mojca/midiatonerca/3d-design/revision6/FullPlate_68x52_4mm_lever2_4_5.dxf

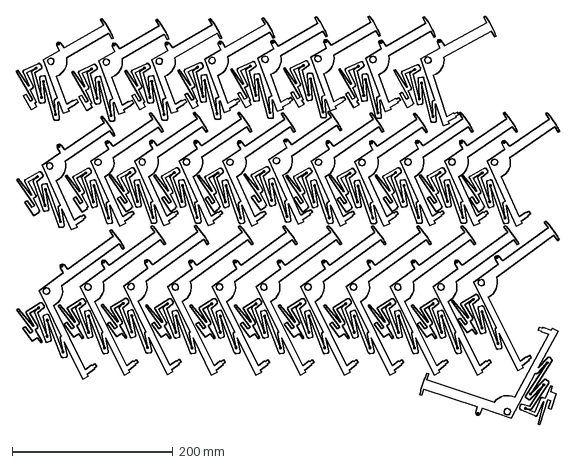
[picture p1: CAD file, 2017-07-26]
3d-design/revision6/FullPlate_68x52_4mm_lever2_4_5.dxf
675.1 x 508.0 mm
