mojca/midiatonerca/3d-design/revision6/FullPlate_53x42_3mm_lever3_32pieces.dxf

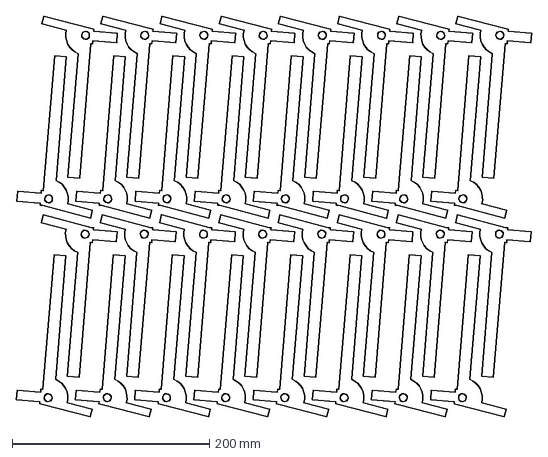
[picture p2: CAD file, 2017-07-26]
3d-design/revision6/FullPlate_53x42_3mm_lever3_32pieces.dxf
522.5 x 406.2 mm
