mojca/midiatonerca/3d-design/revision6/FullPlate_68x40_4mm_frame_aligners.dxf

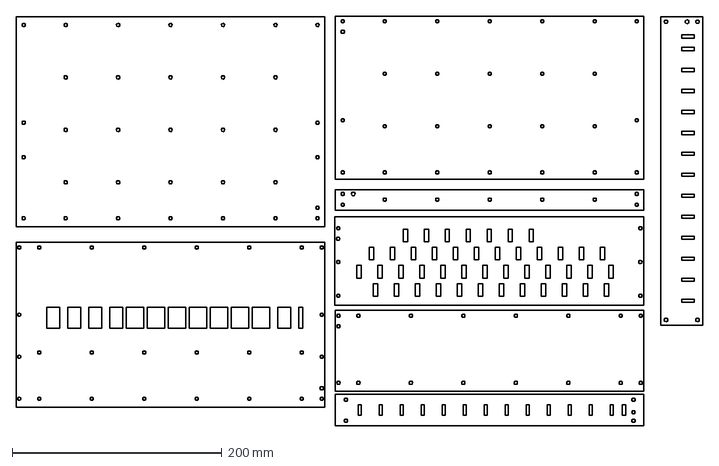
[picture p3: CAD file, 2017-07-26]
3d-design/revision6/FullPlate_68x40_4mm_frame_aligners.dxf
654.0 x 390.5 mm
