mojca/midiatonerca/3d-design/revision6/FullPlate_68x40_4mm_interrupter_omegaholder_lever1_sparelevers.dxf

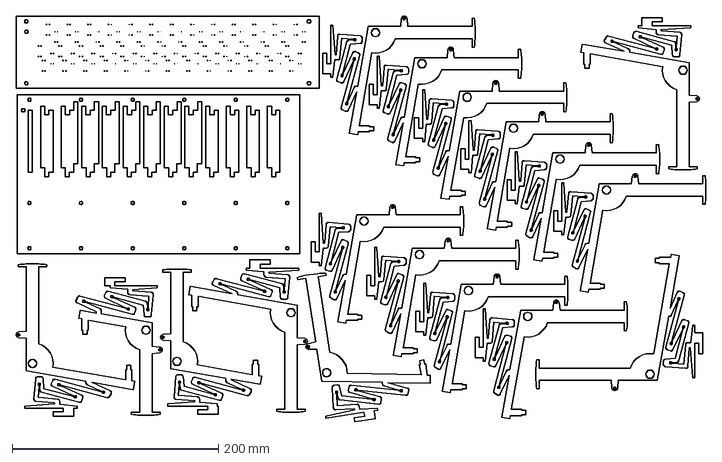
[picture p4: CAD file, 2017-07-26]
3d-design/revision6/FullPlate_68x40_4mm_interrupter_omegaholder_lever1_sparelevers.dxf
668.8 x 393.2 mm
