mojca/midiatonerca/3d-design/revision6/Lever1vH.DXF

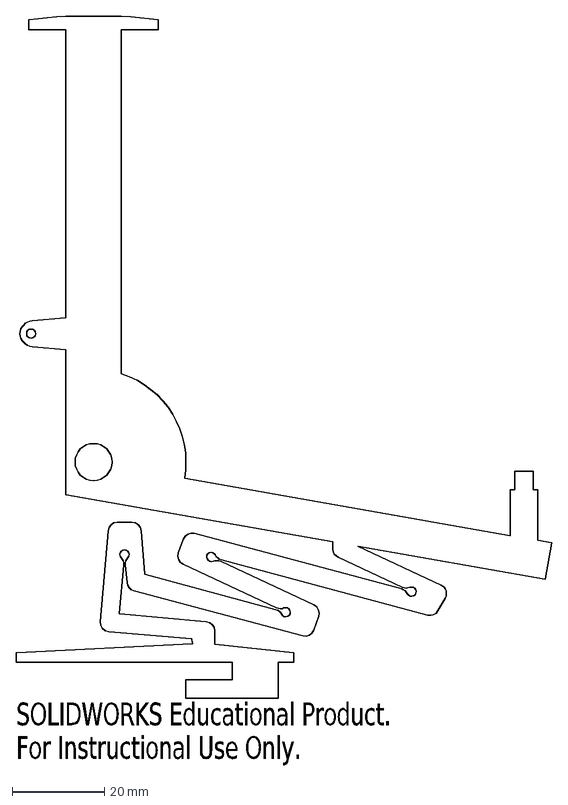
[picture p5: CAD file, 2017-07-26]
3d-design/revision6/Lever1vH.DXF
SOLIDWORKS Educational Product.
For Instructional Use Only.
