mojca/midiatonerca/3d-design/svg-plates/keyboard-holes-for-switches-only/keyboard-holes-for-switches-only-2.dxf

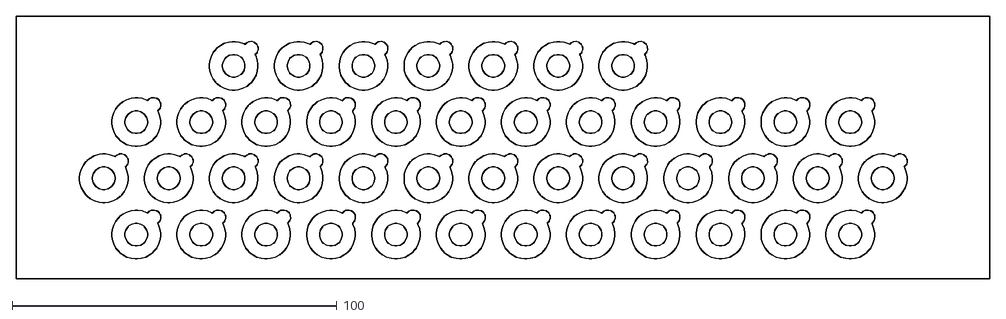
[picture p6: CAD file, 2017-07-27]
3d-design/svg-plates/keyboard-holes-for-switches-only/keyboard-holes-for-switches-only-2.dxf
300.0 x 81.0
