mojca/midiatonerca/3d-design/svg-plates/opto/optocoupler-board.dxf

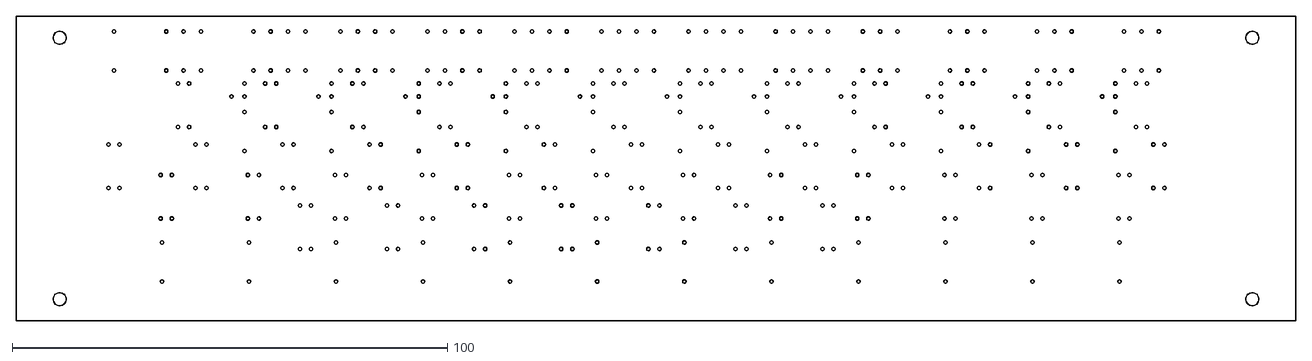
[picture p7: CAD file, 2017-07-28]
3d-design/svg-plates/opto/optocoupler-board.dxf
294.0 x 70.0
