mojca/midiatonerca/3d-design/revision6/OmegaSpringHolderH.DXF

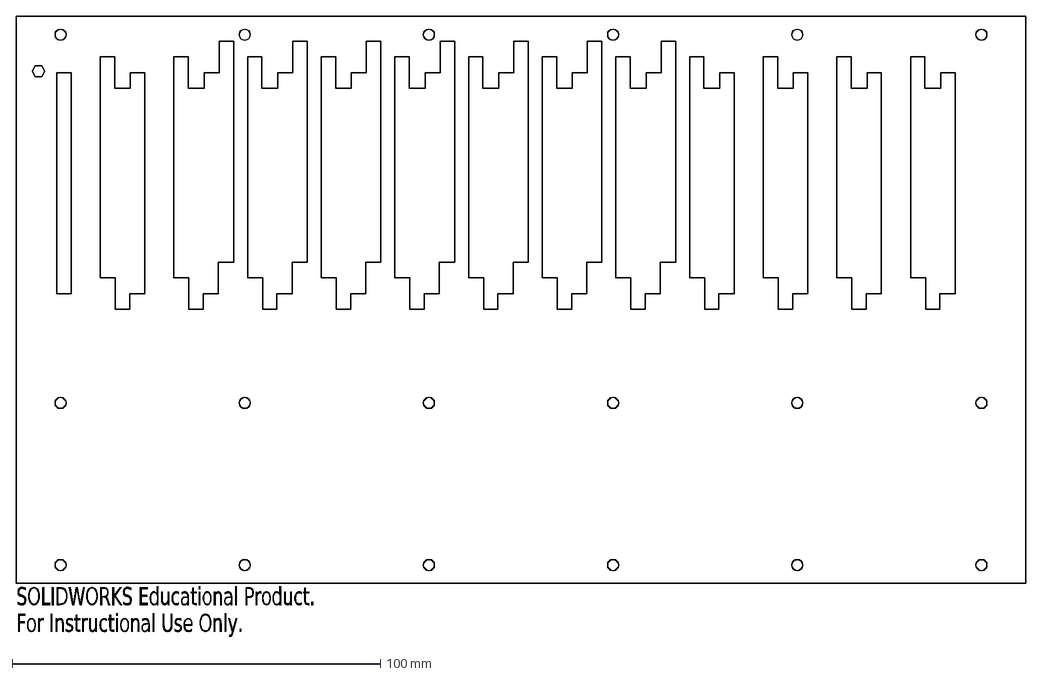
[picture p8: CAD file, 2017-07-26]
3d-design/revision6/OmegaSpringHolderH.DXF
SOLIDWORKS Educational Product.
For Instructional Use Only.
