mojca/midiatonerca/3d-design/svg-plates/keyboard-holes-for-switches-only/keyboard-holes-for-switches-only-3.dxf

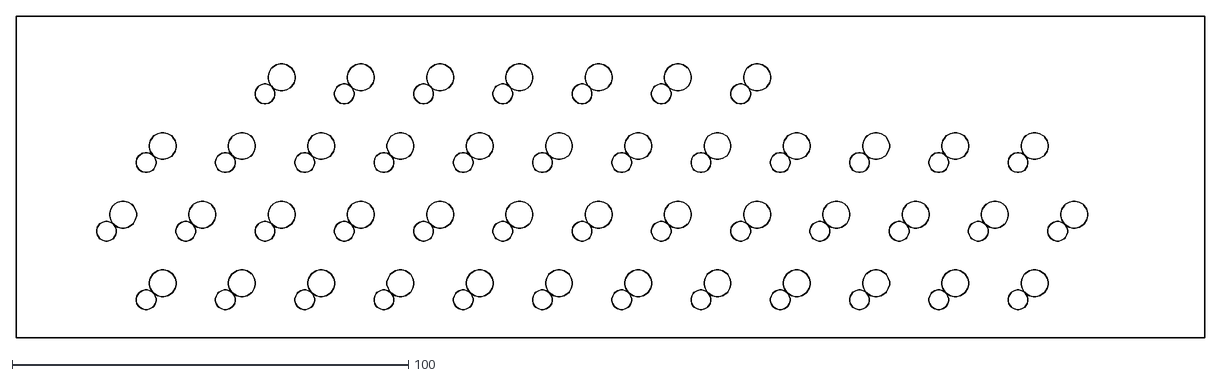
[picture p9: CAD file, 2017-07-26]
3d-design/svg-plates/keyboard-holes-for-switches-only/keyboard-holes-for-switches-only-3.dxf
300.0 x 81.0
