mojca/midiatonerca/3d-design/revision6/BottomPlateH.DXF

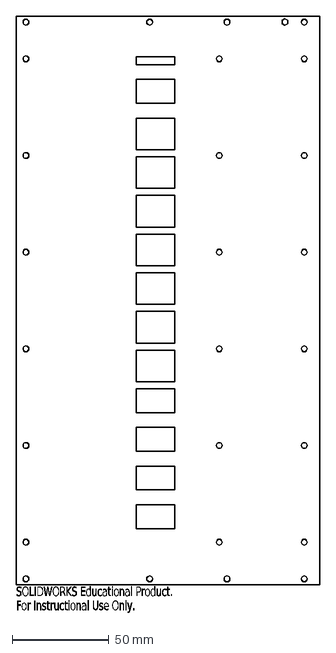
[picture p10: CAD file, 2017-07-26]
3d-design/revision6/BottomPlateH.DXF
SOLIDWORKS Educational Product.
For Instructional Use Only.
