mojca/midiatonerca/3d-design/revision6/KeyboardPlateH.DXF

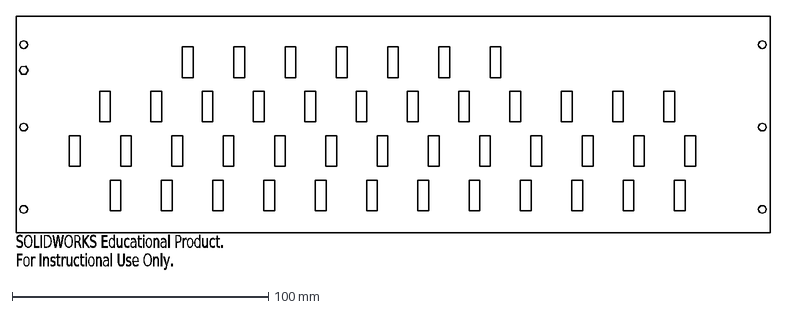
[picture p11: CAD file, 2017-07-26]
3d-design/revision6/KeyboardPlateH.DXF
SOLIDWORKS Educational Product.
For Instructional Use Only.
