mojca/midiatonerca/3d-design/svg-plates/keyboard-holes-for-switches-only/keyboard-holes-for-switches-only-1.dxf

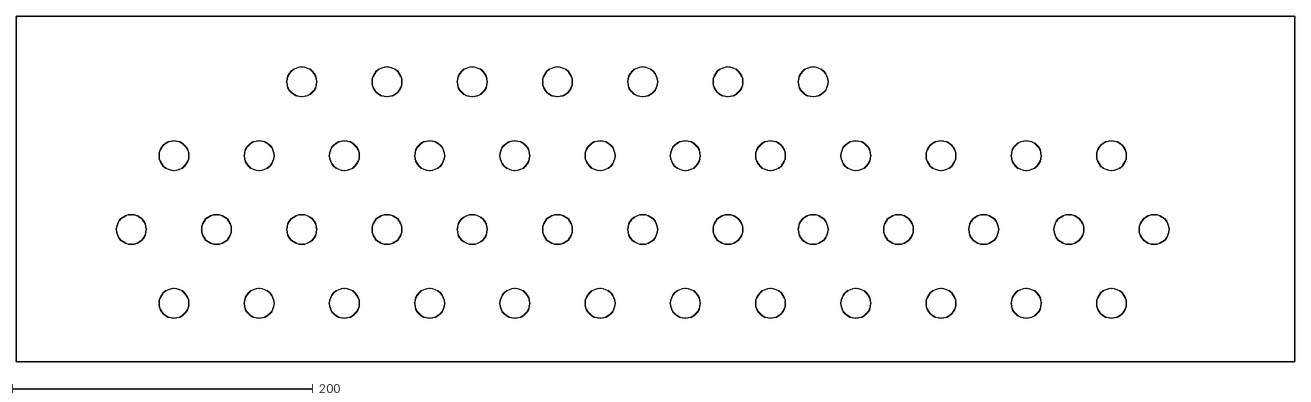
[picture p12: CAD file, 2017-07-24]
3d-design/svg-plates/keyboard-holes-for-switches-only/keyboard-holes-for-switches-only-1.dxf
850.4 x 229.6
