mojca/midiatonerca/3d-design/revision6/Lever5vH.DXF

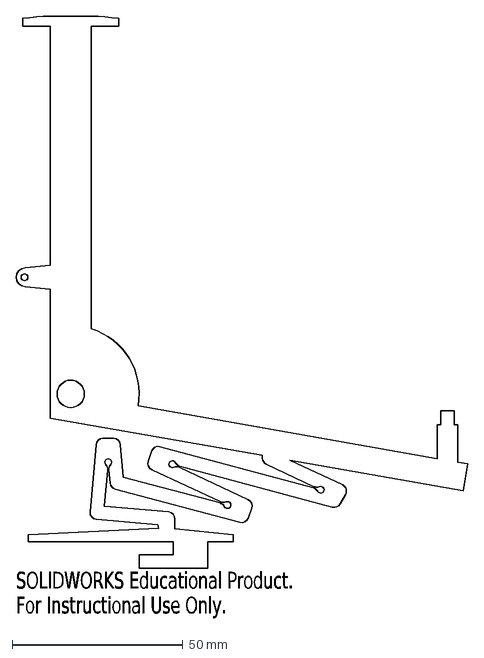
[picture p13: CAD file, 2017-07-26]
3d-design/revision6/Lever5vH.DXF
SOLIDWORKS Educational Product.
For Instructional Use Only.
