mojca/midiatonerca/3d-design/revision6/SidePlateH.DXF

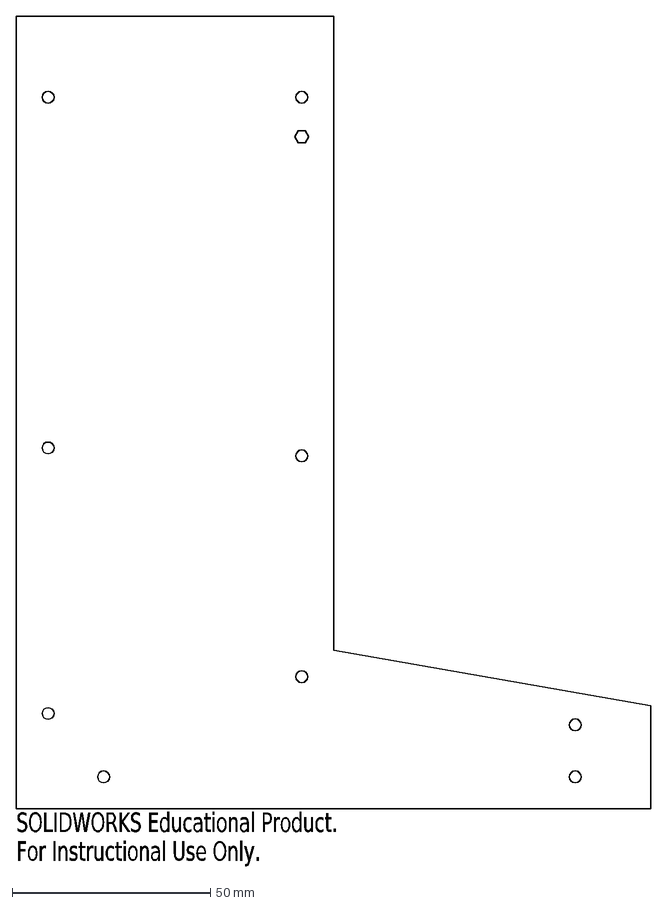
[picture p14: CAD file, 2017-07-26]
3d-design/revision6/SidePlateH.DXF
SOLIDWORKS Educational Product.
For Instructional Use Only.
