mojca/midiatonerca/3d-design/revision6/BackPlateH.DXF

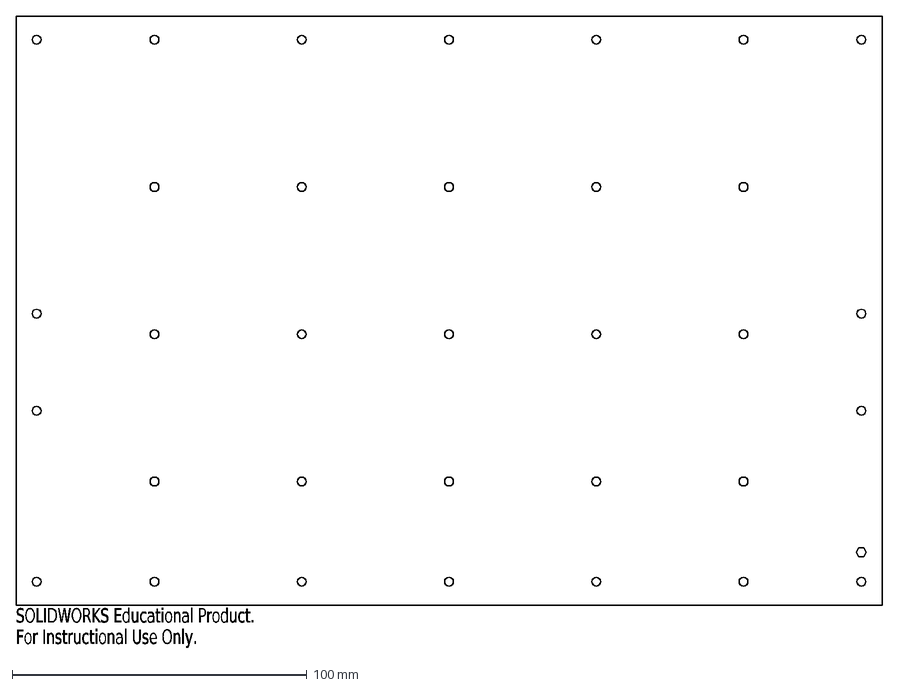
[picture p15: CAD file, 2017-07-26]
3d-design/revision6/BackPlateH.DXF
SOLIDWORKS Educational Product.
For Instructional Use Only.
