mojca/midiatonerca/3d-design/revision6/Lever4vH.DXF

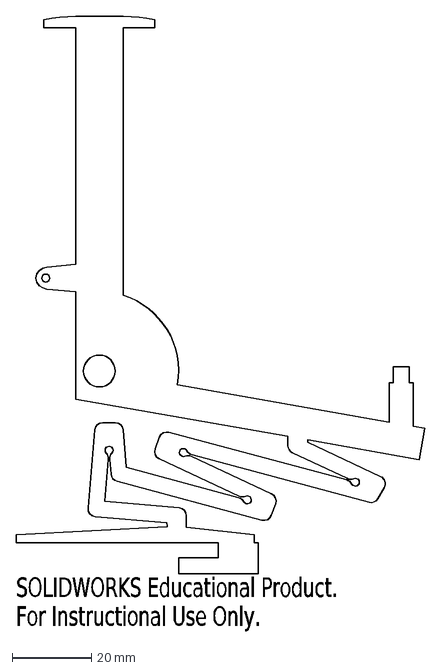
[picture p16: CAD file, 2017-07-26]
3d-design/revision6/Lever4vH.DXF
SOLIDWORKS Educational Product.
For Instructional Use Only.
