mojca/midiatonerca/3d-design/revision6/CoverPlateH.DXF

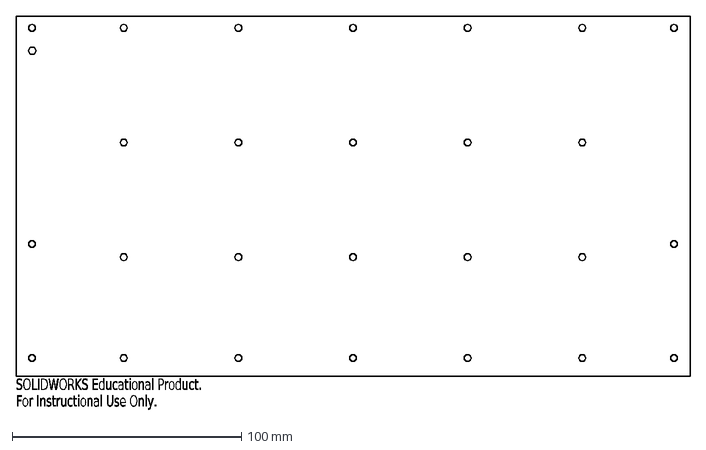
[picture p17: CAD file, 2017-07-26]
3d-design/revision6/CoverPlateH.DXF
SOLIDWORKS Educational Product.
For Instructional Use Only.
