mojca/midiatonerca/3d-design/revision6/DummyLever3vH.DXF

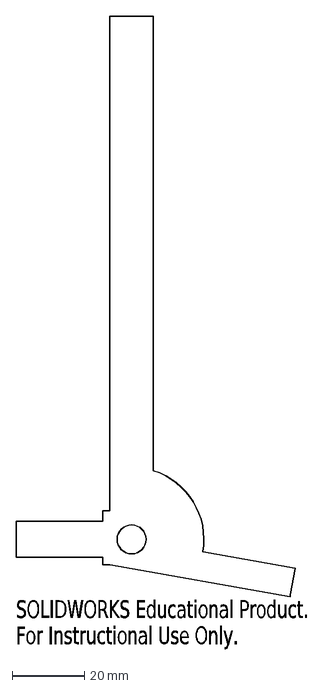
[picture p18: CAD file, 2017-07-26]
3d-design/revision6/DummyLever3vH.DXF
SOLIDWORKS Educational Product.
For Instructional Use Only.
