mojca/midiatonerca/3d-design/revision6/LeverAlignerPivotH.DXF

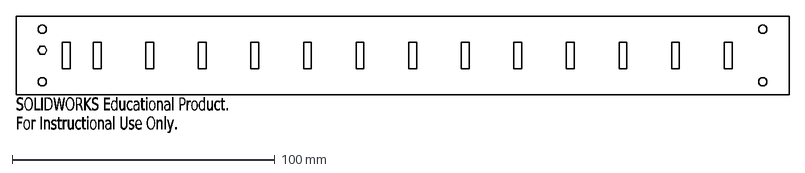
[picture p19: CAD file, 2017-07-26]
3d-design/revision6/LeverAlignerPivotH.DXF
SOLIDWORKS Educational Product.
For Instructional Use Only.
