mojca/midiatonerca/3d-design/revision6/FrontPlateH.DXF

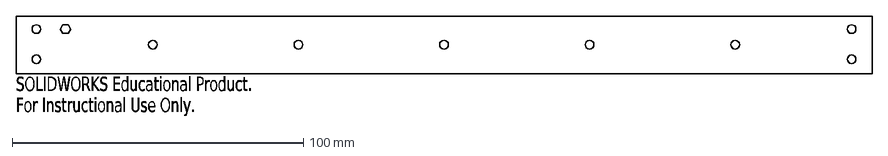
[picture p20: CAD file, 2017-07-26]
3d-design/revision6/FrontPlateH.DXF
SOLIDWORKS Educational Product.
For Instructional Use Only.
