mojca/midiatonerca/3d-design/revision6/TopPlateH.DXF

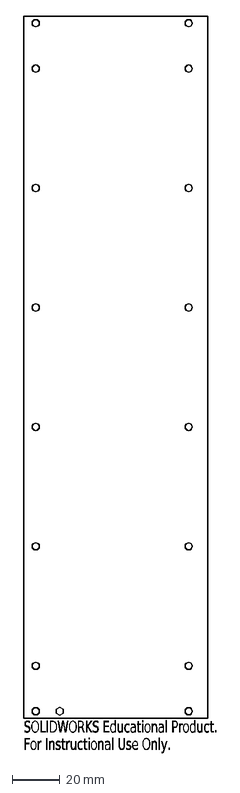
[picture p21: CAD file, 2017-07-26]
3d-design/revision6/TopPlateH.DXF
SOLIDWORKS Educational Product.
For Instructional Use Only.
