mojca/midiatonerca/3d-design/revision6/InterrupterBoardH.DXF

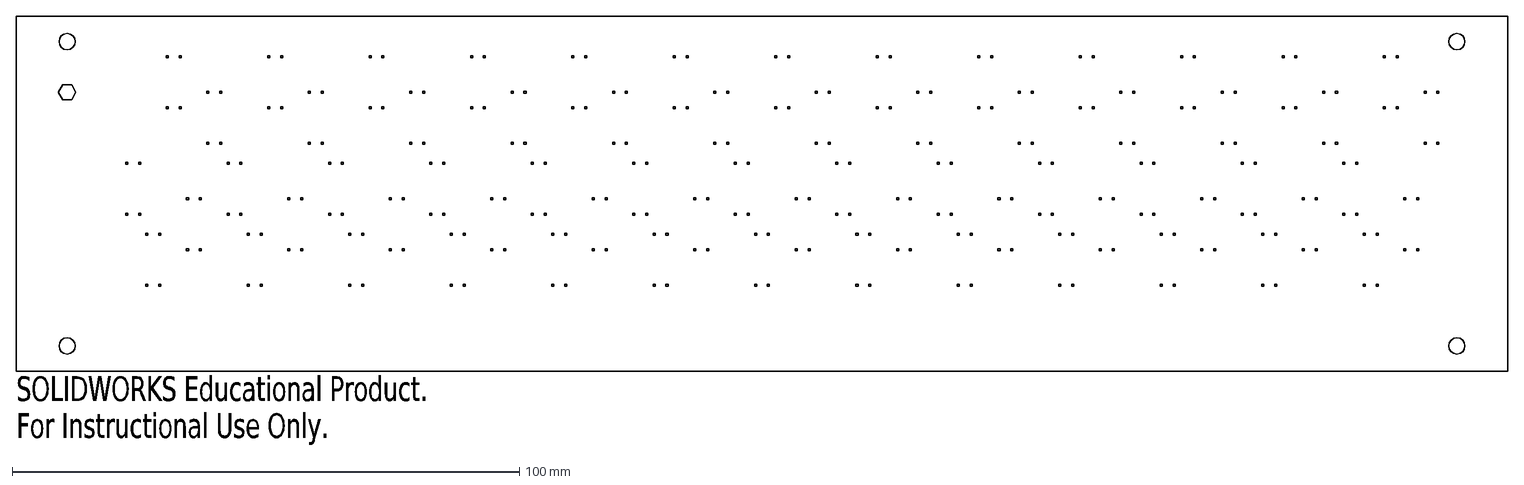
[picture p22: CAD file, 2017-07-26]
3d-design/revision6/InterrupterBoardH.DXF
SOLIDWORKS Educational Product.
For Instructional Use Only.
