mojca/midiatonerca/3d-design/revision6/LeverAlignerTopH.DXF

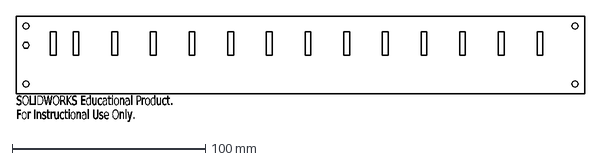
[picture p23: CAD file, 2017-07-26]
3d-design/revision6/LeverAlignerTopH.DXF
SOLIDWORKS Educational Product.
For Instructional Use Only.
