mojca/midiatonerca/3d-design/revision6/Lever2vH.DXF

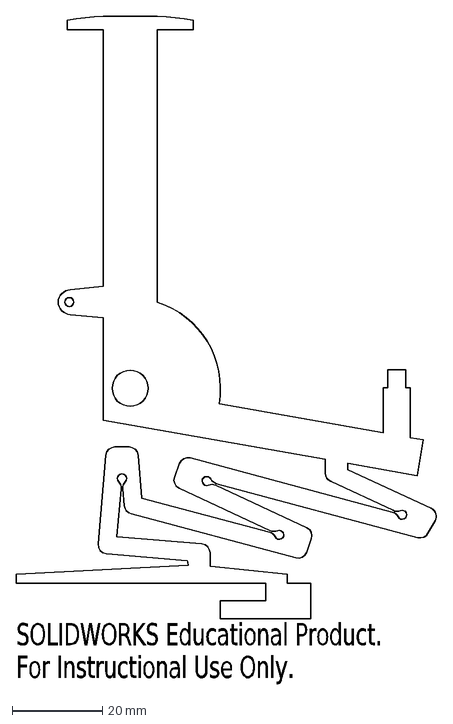
[picture p24: CAD file, 2017-07-26]
3d-design/revision6/Lever2vH.DXF
SOLIDWORKS Educational Product.
For Instructional Use Only.
