mojca/midiatonerca/3d-design/revision6/HalfPlate_64x50_4mm_SideCovers_2x.dxf

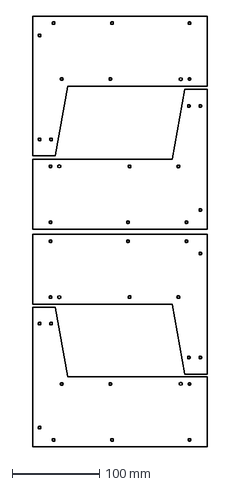
[picture p25: CAD file, 2017-07-26]
3d-design/revision6/HalfPlate_64x50_4mm_SideCovers_2x.dxf
200.0 x 492.9 mm
