mojca/midiatonerca/(list of files, cad)

Other CAD files:
3d-design/revision3/DummyLever3v3.dxf
3d-design/revision3/KeyboardPlatev3.dxf
3d-design/revision3/Lever1v3.dxf
3d-design/revision3/Lever2v3.dxf
3d-design/revision3/Lever4v3.dxf
3d-design/revision3/Lever5v3.dxf
3d-design/revision3/LeverAlignerPivotv3.dxf
3d-design/revision3/LeverAlignerTopv3.dxf
3d-design/revision3/OmegaSpringHolderv3.dxf
3d-design/revision4/Lever1f.dxf
3d-design/revision4/Lever2f.dxf
3d-design/revision4/Lever3f_3mm.dxf
3d-design/revision4/Lever4f.dxf
3d-design/revision4/Lever5f.dxf
3d-design/revision4/OmegaSpringHolder_f.dxf
