mojca/midiatonerca/3d-design/svg-plates/opto/optocoupler-board.pdf

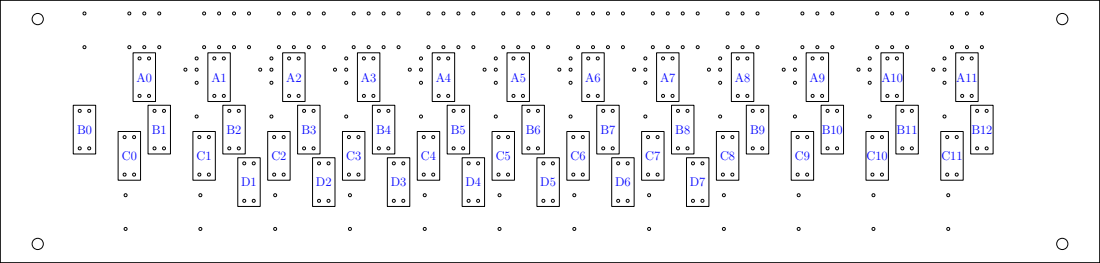
[picture p26: page 1]
