mojca/midiatonerca/kicad/rpi-audio-hat/rpi-audio-hat.kicad_pcb

## KiCad design kicad/rpi-audio-hat/rpi-audio-hat.kicad_pcb (2024-03-06)

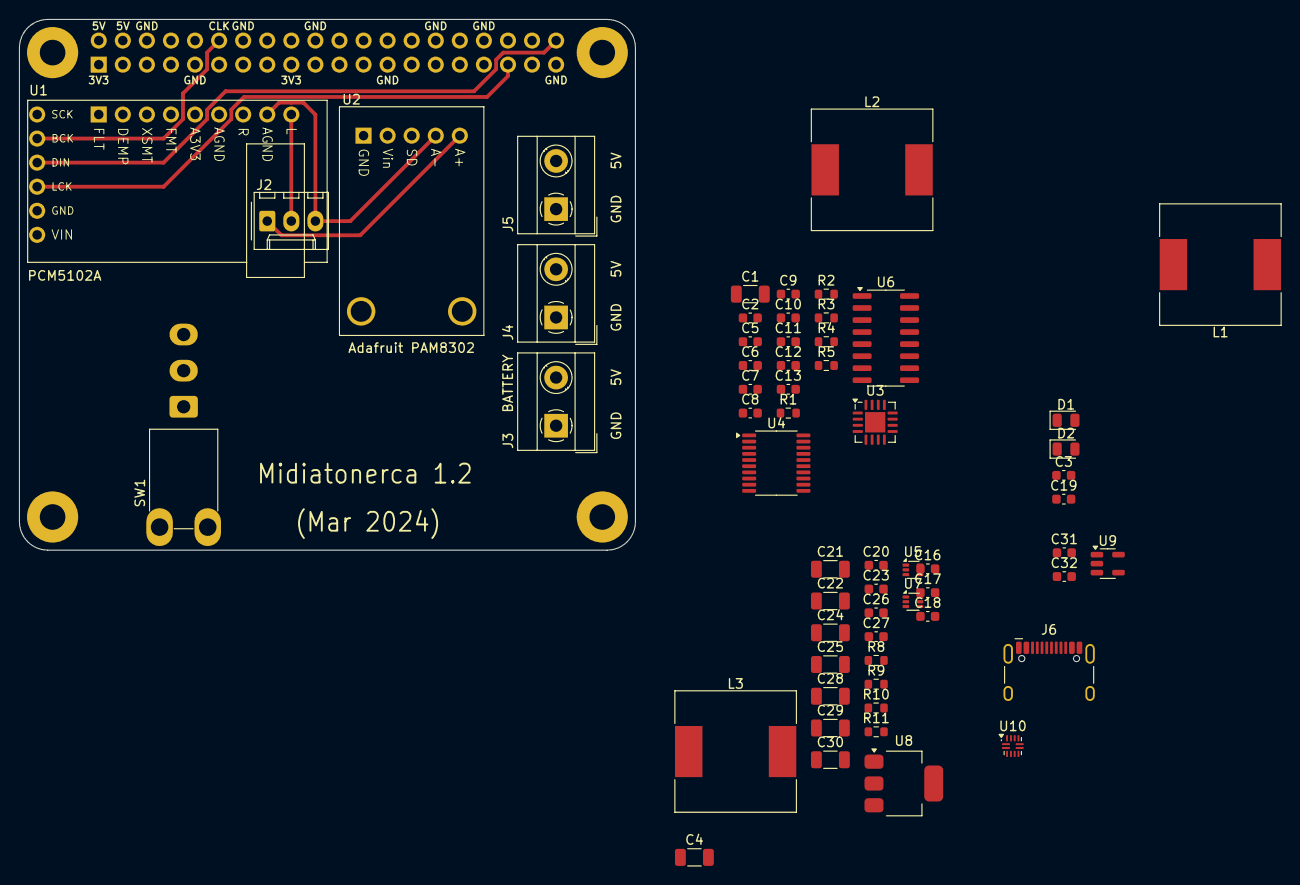
[picture p27: board rpi-audio-hat.kicad_pcb from above]

Board: 4 copper layers, 65.0 x 56.0 mm, 61 parts (1 on the bottom side), 46 nets.

Parts:
C1, C4, C21, C22, C24, C25, C28, C29, C30: 22uF; C_1206_3216Metric
C2, C3, C6, C7, C9, C13, C19, C20, C26: 100nF; C_0603_1608Metric
C5, C8, C10, C11, C12, C18, C31, C32: 10uF; C_0603_1608Metric
C16, C17: 1uF; C_0603_1608Metric
C23, C27: 22pF; C_0603_1608Metric
D1: Green; LED_0805_2012Metric
D2: Red; LED_0805_2012Metric
J1: Raspberry_Pi_2_3; PinSocket_2x20_P2.54mm_Vertical
J2: Conn_Volume_Slider; Molex_KK-254_AE-6410-03A_1x03_P2.54mm_Vertical
J3, J4, J5: Screw_Terminal_01x02; TerminalBlock_MetzConnect_Type101_RT01602HBWC_1x02_P5.08mm_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
J6: USB_C_Receptacle_USB2.0; USB_C_Receptacle_HCTL_HC-TYPE-C-16P-01A
L1, L2, L3: 3A+ 2.2uH; L_SXN_SMDRI124
R1: 3.9k; R_0603_1608Metric
R2, R3: 220R; R_0603_1608Metric
R4, R5: 100k; R_0603_1608Metric
R8, R10: 220k; R_0603_1608Metric
R9: 30k; R_0603_1608Metric
R11: 22k; R_0603_1608Metric
SW1: SW_SPDT; SW_3P_Mini_Toggle_B068BW_SPDT
U1: PCM5102_breakout
U2: PAM8302A_Adafruit_Board; PAM8302
U3: SLM6800; QFN-16-1EP_4x4mm_P0.65mm_EP2.15x2.15mm
U4: PCM5102A; TSSOP-20_4.4x6.5mm_P0.65mm
U5, U7: TPS563203; SOT-563
U6: PAM8406D; SOP-16_3.9x9.9mm_P1.27mm
U8: TLV76150DCYR; SOT-223-3_TabPin2
U9: LP2985-3.3; SOT-23-5
U10: FUSB303BTMX; Texas_X2QFN-12_1.6x1.6mm_P0.4mm

Connections:
+3.3V: J1.1 (3V3), J1.17 (3V3)
+3.3VA: C5.1, C6.1, C7.1, U4.1 (CPVDD), U4.8 (AVDD), U4.17 (XSMT)
+3V3: C8.1, C9.1, R2.1, R3.1, U4.20 (DVDD)
+5V: C21.1, C23.1, C24.1, J1.2 (5V), J1.4 (5V), J4.2, J5.2, L2.2, R4.1, R8.1, SW1.3 (C), U1.15 (VIN), U2.2 (VDD)
+5VA: C30.1, C31.1, U6.4 (PVDDL), U6.5 (~MUTE), U6.6 (VDD), U6.9 (MODE), U6.12 (~SHND), U6.13 (PVDDR), U8.3 (OUT), U9.1 (VIN), U9.3 (ON/~OFF)
+5VP: J3.2, SW1.2 (B)
+6.6V: C27.1, C28.1, L3.2, R10.1
+VBAT: C22.1, C25.1, U3.9 (BAT), U5.1 (VIN), U5.5 (EN), U7.1 (VIN), U7.5 (EN)
/Battery charger/5VIn: C1.1, C2.1, L1.1, U3.2 (VIN), U3.16 (EN)
/Battery charger/USB-D+: J6.A6 (D+), J6.B6 (D+)
/Battery charger/USB-D-: J6.A7 (D-), J6.B7 (D-)
A+: J2.2, U1.9 (OUTL)
A-: J2.3, U1.8 (AGNDL), U2.4 (IN-)
GND: C1.2, C2.2, C4.2, C5.2, C6.2, C7.2, C8.2, C9.2, C10.2, C12.2, C13.2, C18.2, C19.2, C21.2, C22.2, C24.2, C25.2, C28.2, C29.2, C30.2, C31.2, C32.2, J1.6 (GND), J1.9 (GND), J1.14 (GND), J1.20 (GND), J1.25 (GND), J1.30 (GND), J1.34 (GND), J1.39 (GND), J3.1, J4.1, J5.1, J6.A1 (GND), J6.A12 (GND), J6.B1 (GND), J6.B12 (GND), J6.S1 (SHIELD), R1.2, R5.2, R9.2, R11.2, U1.10 (SCK), U1.14 (GND), U2.1 (GND), U3.4 (PGND), U3.15 (SGND), U3.17 (PGND), U4.3 (CPGND), U4.9 (AGND), U4.10 (DEMP), U4.11 (FLT), U4.16 (FMT), U4.19 (DGND), U5.3 (GND), U6.2 (PGNDL), U6.11 (GND), U6.15 (PGNDR), U7.3 (GND), U8.2 (GND), U9.2 (GND), U10.10 (GND)
unnamed: C3.1, L1.2, U3.5 (LX), U3.6 (LX)
unnamed: C4.1, U3.7 (VSYS), U3.8 (VSYS)
unnamed: D1.2 (A), R2.2
unnamed: D1.1 (K), U3.13 (~CHRG)
unnamed: D2.2 (A), R3.2
unnamed: D2.1 (K), U3.14 (~STBY)
unnamed: J6.A5 (CC1), U10.1 (CC1)
unnamed: J6.B5 (CC2), U10.2 (CC2)
unnamed: C3.2, U3.3 (BST)
unnamed: R1.1, U3.11 (ISET)
unnamed: R4.2, R5.1, U3.1 (NTC)
unnamed: C19.1, U3.12 (TM)
unnamed: C11.2, U4.4 (CAPM)
unnamed: C11.1, U4.2 (CAPP)
unnamed: C12.1, C13.1, U4.18 (LDOO)
unnamed: C10.1, U4.5 (VNEG)
unnamed: C26.2, U5.4 (BST)
unnamed: C27.2, R10.2, R11.1, U5.6 (FB)
unnamed: C26.1, L3.1, U5.2 (SW)
unnamed: C16.2, U6.7 (INL)
unnamed: C17.2, U6.10 (INR)
unnamed: C18.1, U6.8 (VREF)
unnamed: C20.2, U7.4 (BST)
unnamed: C23.2, R8.2, R9.1, U7.6 (FB)
unnamed: C20.1, L2.1, U7.2 (SW)
unnamed: C29.1, U8.1 (IN)
unnamed: C32.1, U9.5 (VOUT)
VUSB: J6.A4 (VBUS), J6.A9 (VBUS), J6.B4 (VBUS), J6.B9 (VBUS), U10.4 (VBUS_DET)
Volume A+: J2.1, U2.5 (IN+)
rpi12: J1.12 (GPIO18/PWM0), U1.11 (BCK), U4.13 (BCK)
rpi35: J1.35 (GPIO19/MISO1), U1.13 (LRCK), U4.12 (SCK), U4.15 (LRCK)
rpi40: J1.40 (GPIO21/SCLK1), U1.12 (DIN), U4.14 (DIN)
