mojca/midiatonerca/kicad/arduino-plate/arduino-plate.kicad_pcb

## KiCad design kicad/arduino-plate/arduino-plate.kicad_pcb (2024-03-04)

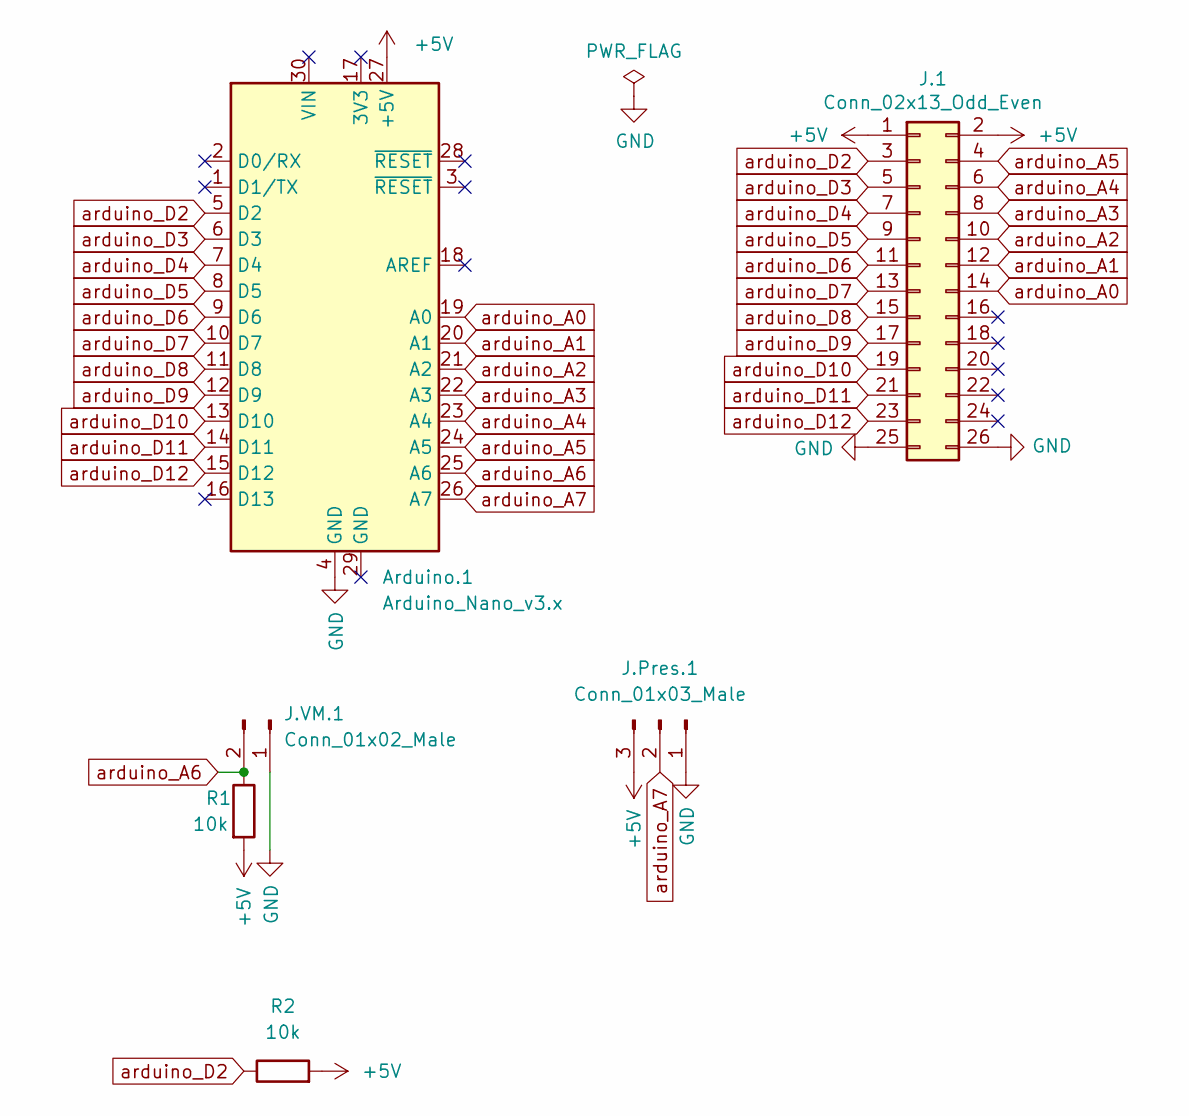
[picture p28: schematic arduino-plate.kicad_sch]

Parts:
Arduino.1: Arduino_Nano_v3.x; Arduino_Nano
J.1: Conn_02x13_Odd_Even; IDC-Header_2x13_P2.54mm_Vertical
J.Pres.1: Conn_01x03_Male; Molex_KK-254_AE-6410-03A_1x03_P2.54mm_Vertical
J.VM.1: Conn_01x02_Male; Molex_KK-254_AE-6410-02A_1x02_P2.54mm_Vertical
R1, R2: 10k; R_1206_3216Metric_Pad1.30x1.75mm_HandSolder

Connections:
+5V: Arduino.1.27 (+5V), J.1.1, J.1.2, J.Pres.1.3, R1.2, R2.2
GND: Arduino.1.4 (GND), J.1.25, J.1.26, J.Pres.1.1, J.VM.1.1
arduino_A0: Arduino.1.19 (A0), J.1.14
arduino_A1: Arduino.1.20 (A1), J.1.12
arduino_A2: Arduino.1.21 (A2), J.1.10
arduino_A3: Arduino.1.22 (A3), J.1.8
arduino_A4: Arduino.1.23 (A4), J.1.6
arduino_A5: Arduino.1.24 (A5), J.1.4
arduino_A6: Arduino.1.25 (A6), J.VM.1.2, R1.1
arduino_A7: Arduino.1.26 (A7), J.Pres.1.2
arduino_D2: Arduino.1.5 (D2), J.1.3, R2.1
arduino_D3: Arduino.1.6 (D3), J.1.5
arduino_D4: Arduino.1.7 (D4), J.1.7
arduino_D5: Arduino.1.8 (D5), J.1.9
arduino_D6: Arduino.1.9 (D6), J.1.11
arduino_D7: Arduino.1.10 (D7), J.1.13
arduino_D8: Arduino.1.11 (D8), J.1.15
arduino_D9: Arduino.1.12 (D9), J.1.17
arduino_D10: Arduino.1.13 (D10), J.1.19
arduino_D11: Arduino.1.14 (D11), J.1.21
arduino_D12: Arduino.1.15 (D12), J.1.23

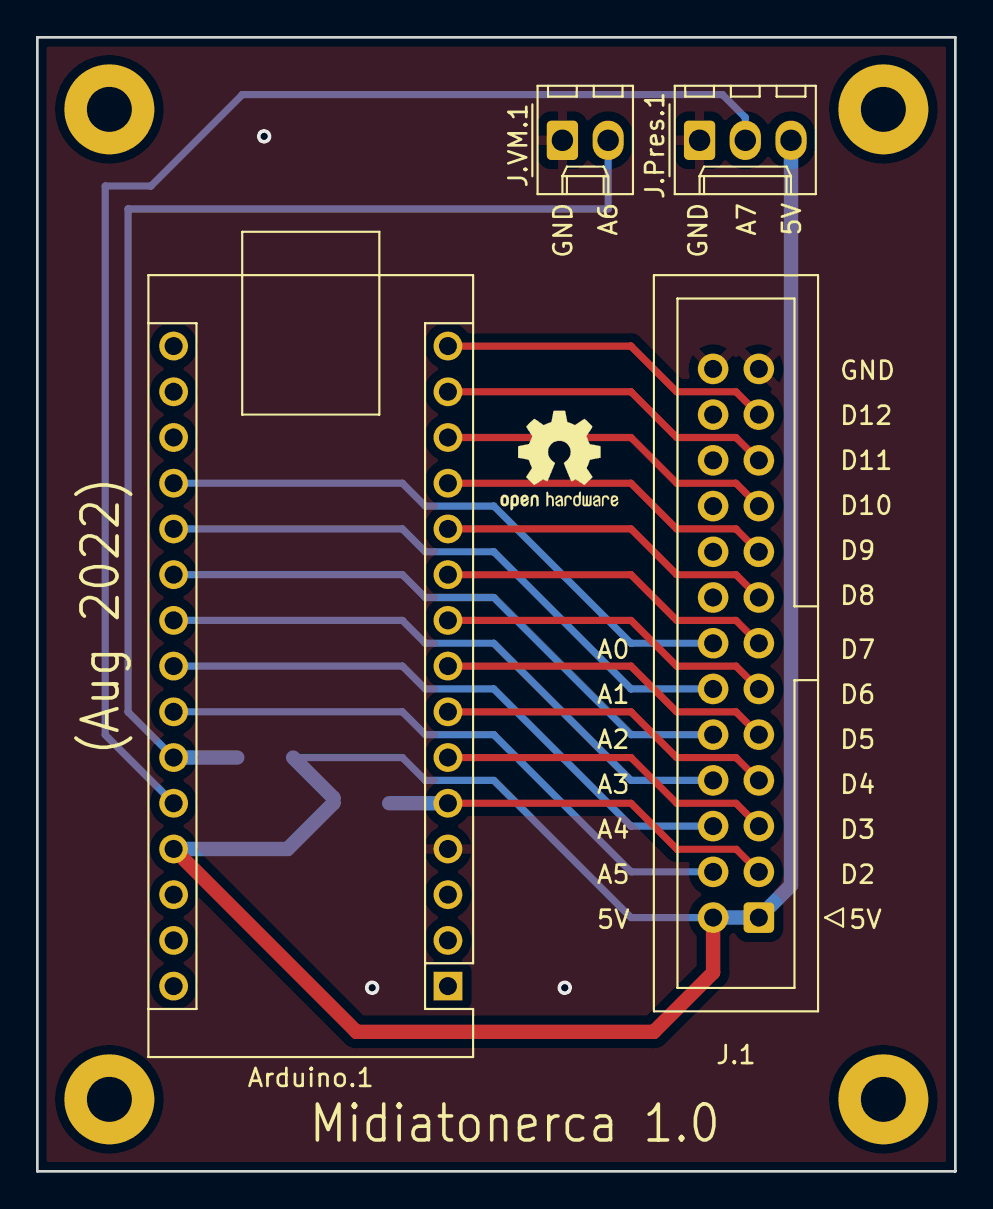
[picture p29: board arduino-plate.kicad_pcb from above]

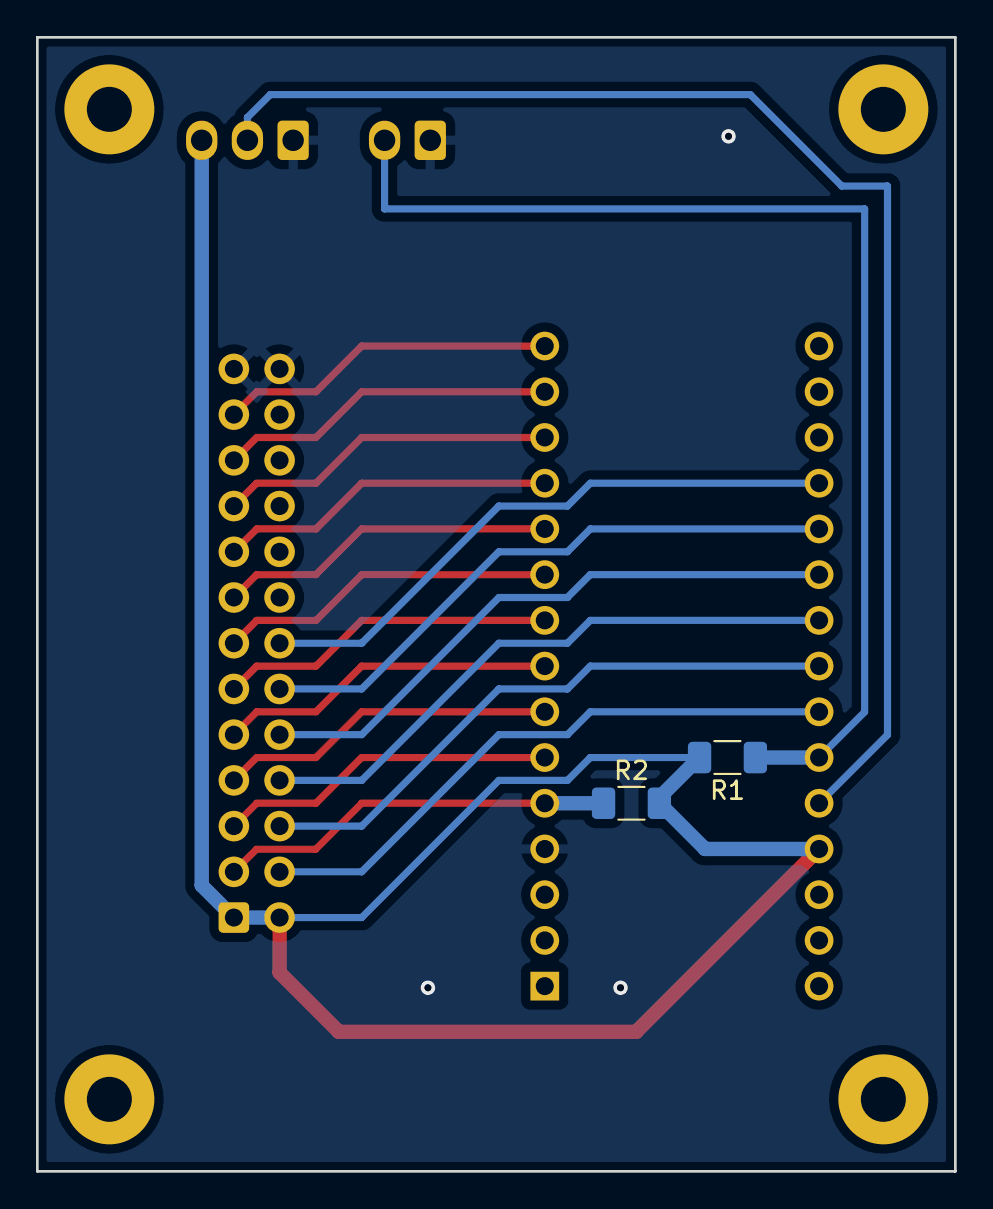
[picture p30: board arduino-plate.kicad_pcb from below]

Board: 2 copper layers, 51.0 x 63.0 mm, 6 parts (2 on the bottom side), 21 nets.
