mojca/midiatonerca/kicad/led-strip-levers/led-strip-levers.kicad_pcb

## KiCad design kicad/led-strip-levers/led-strip-levers.kicad_pcb (2024-03-04)

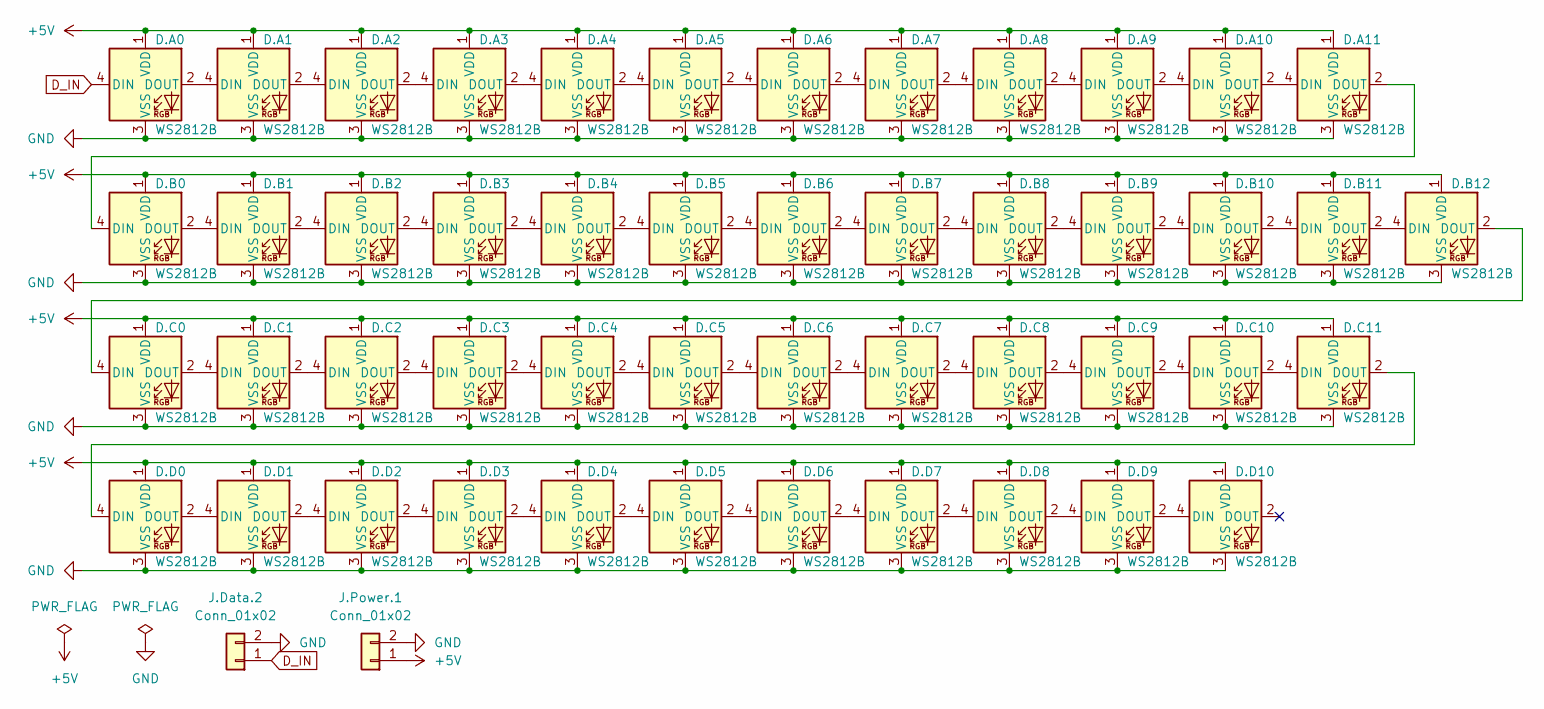
[picture p31: schematic led-strip-levers.kicad_sch]

Parts:
D.A0, D.A1, D.A2, D.A3, D.A4, D.A5, D.A6, D.A7, D.A8, D.A9, D.A10, D.A11, D.B0, D.B1, D.B2, D.B3, D.B4, D.B5, D.B6, D.B7, D.B8, D.B9, D.B10, D.B11, D.B12, D.C0, D.C1, D.C2, D.C3, D.C4, D.C5, D.C6, D.C7, D.C8, D.C9, D.C10, D.C11, D.D0, D.D1, D.D2, D.D3, D.D4, D.D5, D.D6, D.D7, D.D8, D.D9, D.D10: WS2812B; LED_WS2812B-Mini_PLCC4_3.5x3.5mm_P1.8mm; LCSC Part # C527089
J.Data.2, J.Power.1: Conn_01x02

Connections:
+5V: D.A0.1 (VDD), D.A1.1 (VDD), D.A2.1 (VDD), D.A3.1 (VDD), D.A4.1 (VDD), D.A5.1 (VDD), D.A6.1 (VDD), D.A7.1 (VDD), D.A8.1 (VDD), D.A9.1 (VDD), D.A10.1 (VDD), D.A11.1 (VDD), D.B0.1 (VDD), D.B1.1 (VDD), D.B2.1 (VDD), D.B3.1 (VDD), D.B4.1 (VDD), D.B5.1 (VDD), D.B6.1 (VDD), D.B7.1 (VDD), D.B8.1 (VDD), D.B9.1 (VDD), D.B10.1 (VDD), D.B11.1 (VDD), D.B12.1 (VDD), D.C0.1 (VDD), D.C1.1 (VDD), D.C2.1 (VDD), D.C3.1 (VDD), D.C4.1 (VDD), D.C5.1 (VDD), D.C6.1 (VDD), D.C7.1 (VDD), D.C8.1 (VDD), D.C9.1 (VDD), D.C10.1 (VDD), D.C11.1 (VDD), D.D0.1 (VDD), D.D1.1 (VDD), D.D2.1 (VDD), D.D3.1 (VDD), D.D4.1 (VDD), D.D5.1 (VDD), D.D6.1 (VDD), D.D7.1 (VDD), D.D8.1 (VDD), D.D9.1 (VDD), D.D10.1 (VDD), J.Power.1.1
D_IN: D.A0.4 (DIN), J.Data.2.1
GND: D.A0.3 (VSS), D.A1.3 (VSS), D.A2.3 (VSS), D.A3.3 (VSS), D.A4.3 (VSS), D.A5.3 (VSS), D.A6.3 (VSS), D.A7.3 (VSS), D.A8.3 (VSS), D.A9.3 (VSS), D.A10.3 (VSS), D.A11.3 (VSS), D.B0.3 (VSS), D.B1.3 (VSS), D.B2.3 (VSS), D.B3.3 (VSS), D.B4.3 (VSS), D.B5.3 (VSS), D.B6.3 (VSS), D.B7.3 (VSS), D.B8.3 (VSS), D.B9.3 (VSS), D.B10.3 (VSS), D.B11.3 (VSS), D.B12.3 (VSS), D.C0.3 (VSS), D.C1.3 (VSS), D.C2.3 (VSS), D.C3.3 (VSS), D.C4.3 (VSS), D.C5.3 (VSS), D.C6.3 (VSS), D.C7.3 (VSS), D.C8.3 (VSS), D.C9.3 (VSS), D.C10.3 (VSS), D.C11.3 (VSS), D.D0.3 (VSS), D.D1.3 (VSS), D.D2.3 (VSS), D.D3.3 (VSS), D.D4.3 (VSS), D.D5.3 (VSS), D.D6.3 (VSS), D.D7.3 (VSS), D.D8.3 (VSS), D.D9.3 (VSS), D.D10.3 (VSS), J.Data.2.2, J.Power.1.2
unnamed: D.A0.2 (DOUT), D.A1.4 (DIN)
unnamed: D.A1.2 (DOUT), D.A2.4 (DIN)
unnamed: D.A2.2 (DOUT), D.A3.4 (DIN)
unnamed: D.A3.2 (DOUT), D.A4.4 (DIN)
unnamed: D.A4.2 (DOUT), D.A5.4 (DIN)
unnamed: D.A5.2 (DOUT), D.A6.4 (DIN)
unnamed: D.A6.2 (DOUT), D.A7.4 (DIN)
unnamed: D.A7.2 (DOUT), D.A8.4 (DIN)
unnamed: D.A8.2 (DOUT), D.A9.4 (DIN)
unnamed: D.A9.2 (DOUT), D.A10.4 (DIN)
unnamed: D.A10.2 (DOUT), D.A11.4 (DIN)
unnamed: D.B0.2 (DOUT), D.B1.4 (DIN)
unnamed: D.A11.2 (DOUT), D.B0.4 (DIN)
unnamed: D.B1.2 (DOUT), D.B2.4 (DIN)
unnamed: D.B2.2 (DOUT), D.B3.4 (DIN)
unnamed: D.B3.2 (DOUT), D.B4.4 (DIN)
unnamed: D.B4.2 (DOUT), D.B5.4 (DIN)
unnamed: D.B5.2 (DOUT), D.B6.4 (DIN)
unnamed: D.B6.2 (DOUT), D.B7.4 (DIN)
unnamed: D.B7.2 (DOUT), D.B8.4 (DIN)
unnamed: D.B8.2 (DOUT), D.B9.4 (DIN)
unnamed: D.B9.2 (DOUT), D.B10.4 (DIN)
unnamed: D.B10.2 (DOUT), D.B11.4 (DIN)
unnamed: D.B11.2 (DOUT), D.B12.4 (DIN)
unnamed: D.C0.2 (DOUT), D.C1.4 (DIN)
unnamed: D.B12.2 (DOUT), D.C0.4 (DIN)
unnamed: D.C1.2 (DOUT), D.C2.4 (DIN)
unnamed: D.C2.2 (DOUT), D.C3.4 (DIN)
unnamed: D.C3.2 (DOUT), D.C4.4 (DIN)
unnamed: D.C4.2 (DOUT), D.C5.4 (DIN)
unnamed: D.C5.2 (DOUT), D.C6.4 (DIN)
unnamed: D.C6.2 (DOUT), D.C7.4 (DIN)
unnamed: D.C7.2 (DOUT), D.C8.4 (DIN)
unnamed: D.C8.2 (DOUT), D.C9.4 (DIN)
unnamed: D.C9.2 (DOUT), D.C10.4 (DIN)
unnamed: D.C10.2 (DOUT), D.C11.4 (DIN)
unnamed: D.D0.2 (DOUT), D.D1.4 (DIN)
unnamed: D.C11.2 (DOUT), D.D0.4 (DIN)
unnamed: D.D1.2 (DOUT), D.D2.4 (DIN)
unnamed: D.D2.2 (DOUT), D.D3.4 (DIN)
unnamed: D.D3.2 (DOUT), D.D4.4 (DIN)
unnamed: D.D4.2 (DOUT), D.D5.4 (DIN)
unnamed: D.D5.2 (DOUT), D.D6.4 (DIN)
unnamed: D.D6.2 (DOUT), D.D7.4 (DIN)
unnamed: D.D7.2 (DOUT), D.D8.4 (DIN)
unnamed: D.D8.2 (DOUT), D.D9.4 (DIN)
unnamed: D.D9.2 (DOUT), D.D10.4 (DIN)

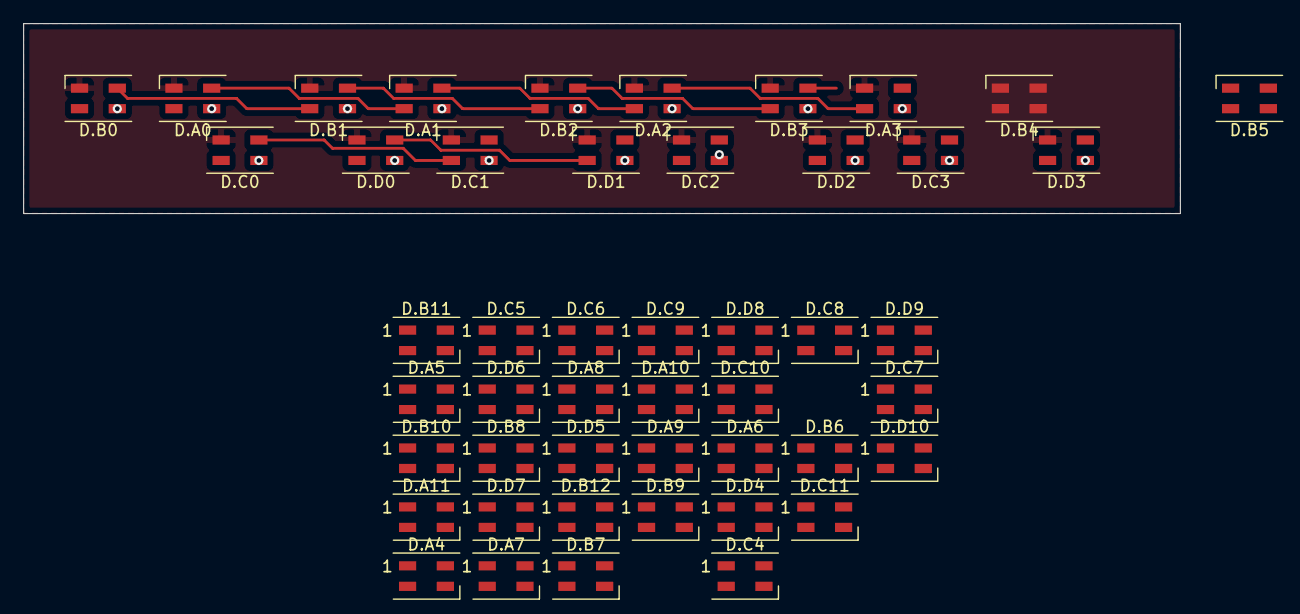
[picture p32: board led-strip-levers.kicad_pcb from above]

Board: 2 copper layers, 100.5 x 16.5 mm, 48 parts (0 on the bottom side), 49 nets.
