mojca/midiatonerca/kicad/led-strip/led-strip.kicad_pcb

## KiCad design kicad/led-strip/led-strip.kicad_pcb (2024-03-04)

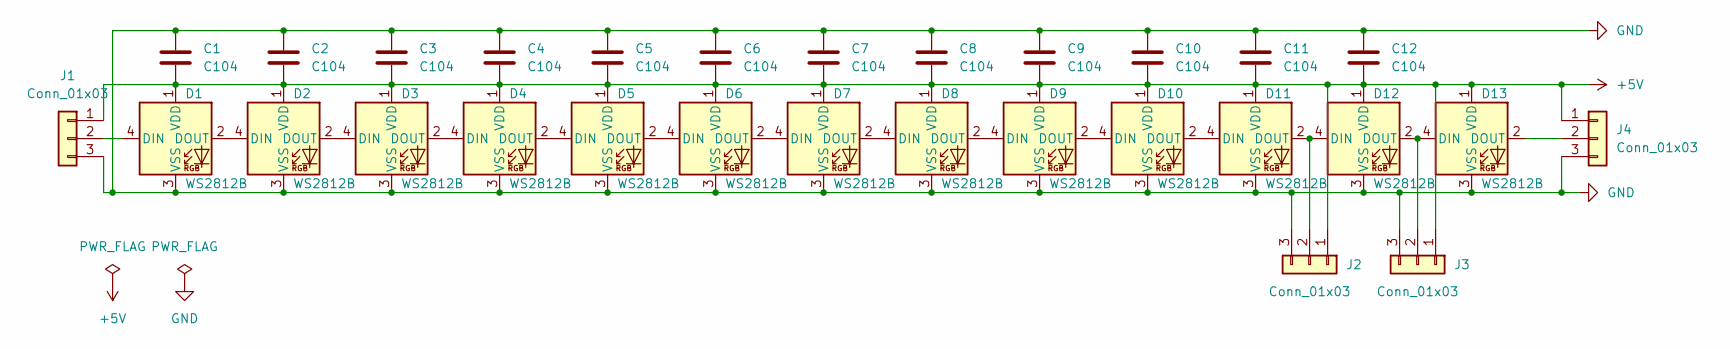
[picture p33: schematic led-strip.kicad_sch]

Parts:
C1, C2, C3, C4, C5, C6, C7, C8, C9, C10, C11, C12: C104; C_1206_3216Metric_Pad1.33x1.80mm_HandSolder; LCSC Part # C24497
D1, D2, D3, D4, D5, D6, D7, D8, D9, D10, D11, D12, D13: WS2812B; LED_WS2812B_PLCC4_5.0x5.0mm_P3.2mm; LCSC Part # C2761795
J1, J2, J3, J4: Conn_01x03; SolderWirePad_1x03_SMD_1x3mm

Connections:
+5V: C1.2, C2.2, C3.2, C4.2, C5.2, C6.2, C7.2, C8.2, C9.2, C10.2, C11.2, C12.2, D1.1 (VDD), D2.1 (VDD), D3.1 (VDD), D4.1 (VDD), D5.1 (VDD), D6.1 (VDD), D7.1 (VDD), D8.1 (VDD), D9.1 (VDD), D10.1 (VDD), D11.1 (VDD), D12.1 (VDD), D13.1 (VDD), J1.1, J2.1, J3.1, J4.1
GND: C1.1, C2.1, C3.1, C4.1, C5.1, C6.1, C7.1, C8.1, C9.1, C10.1, C11.1, C12.1, D1.3 (VSS), D2.3 (VSS), D3.3 (VSS), D4.3 (VSS), D5.3 (VSS), D6.3 (VSS), D7.3 (VSS), D8.3 (VSS), D9.3 (VSS), D10.3 (VSS), D11.3 (VSS), D12.3 (VSS), D13.3 (VSS), J1.3, J2.3, J3.3, J4.3
unnamed: D1.2 (DOUT), D2.4 (DIN)
unnamed: D1.4 (DIN), J1.2
unnamed: D2.2 (DOUT), D3.4 (DIN)
unnamed: D3.2 (DOUT), D4.4 (DIN)
unnamed: D4.2 (DOUT), D5.4 (DIN)
unnamed: D5.2 (DOUT), D6.4 (DIN)
unnamed: D6.2 (DOUT), D7.4 (DIN)
unnamed: D7.2 (DOUT), D8.4 (DIN)
unnamed: D8.2 (DOUT), D9.4 (DIN)
unnamed: D10.2 (DOUT), D11.4 (DIN)
unnamed: D9.2 (DOUT), D10.4 (DIN)
unnamed: D11.2 (DOUT), D12.4 (DIN), J2.2
unnamed: D12.2 (DOUT), D13.4 (DIN), J3.2
unnamed: D13.2 (DOUT), J4.2

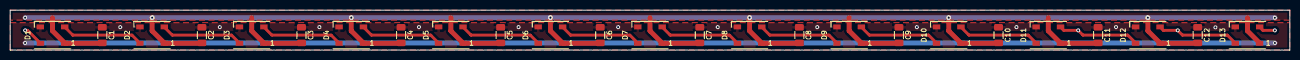
[picture p34: board led-strip.kicad_pcb from above]

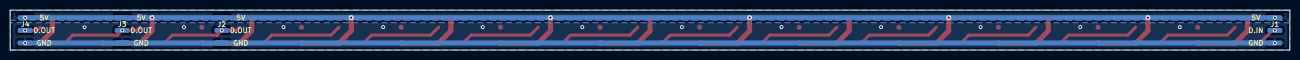
[picture p35: board led-strip.kicad_pcb from below]

Board: 2 copper layers, 257.0 x 8.0 mm, 29 parts (4 on the bottom side), 16 nets.
