mojca/midiatonerca/kicad/cherry-basses/cherry-basses.kicad_pcb

## KiCad design kicad/cherry-basses/cherry-basses.kicad_pcb (2024-03-04)

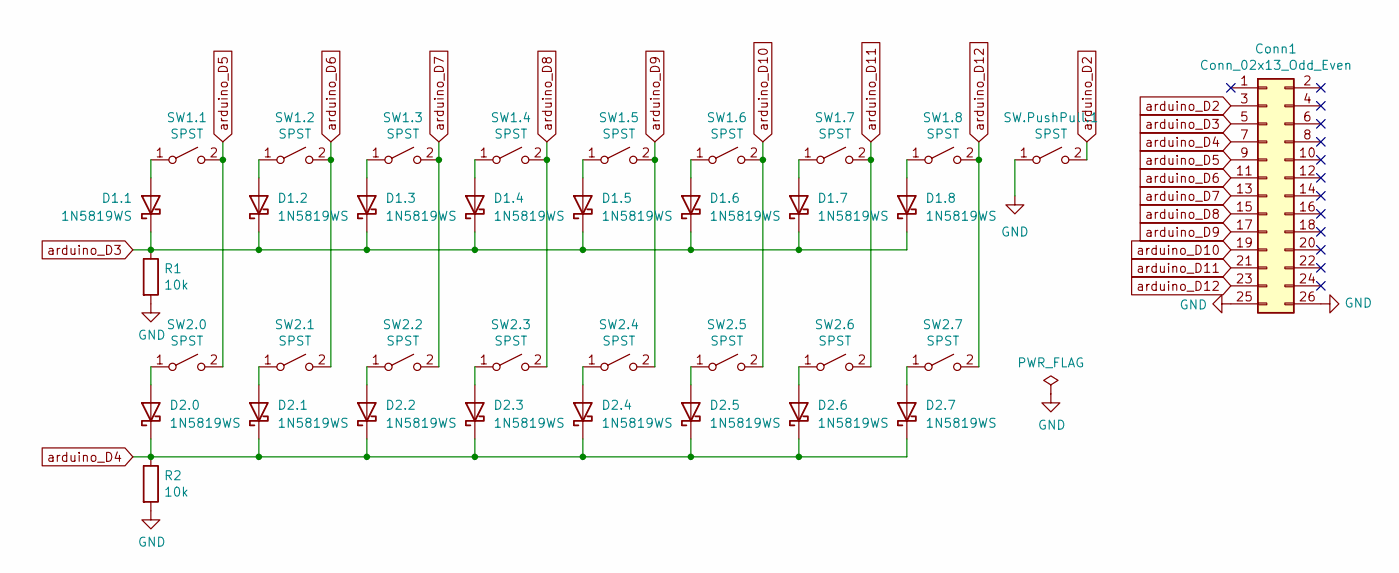
[picture p36: schematic cherry-basses.kicad_sch]

Parts:
Conn1: Conn_02x13_Odd_Even; IDC-Header_2x13_P2.54mm_Vertical; LCSC Part # C692426
D1.1, D1.2, D1.3, D1.4, D1.5, D1.6, D1.7, D1.8, D2.0, D2.1, D2.2, D2.3, D2.4, D2.5, D2.6, D2.7: 1N5819WS; D_SOD-323_HandSoldering; LCSC Part # C191023
R1, R2: 10k; R_1206_3216Metric_Pad1.30x1.75mm_HandSolder; LCSC Part # C17902
SW1.1, SW1.2, SW1.3, SW1.4, SW1.5, SW1.6, SW1.7, SW1.8, SW2.0, SW2.1, SW2.2, SW2.3, SW2.4, SW2.5, SW2.6, SW2.7: SPST; SW_Cherry_MX_1.00u_PCB
SW.PushPull.1: SPST; Molex_KK-254_AE-6410-02A_1x02_P2.54mm_Vertical

Connections:
GND: Conn1.25, Conn1.26, R1.2, R2.2, SW.PushPull.1.1 (A)
unnamed: D1.1.2 (A), SW1.1.1 (A)
unnamed: D1.2.2 (A), SW1.2.1 (A)
unnamed: D1.3.2 (A), SW1.3.1 (A)
unnamed: D1.4.2 (A), SW1.4.1 (A)
unnamed: D1.5.2 (A), SW1.5.1 (A)
unnamed: D1.6.2 (A), SW1.6.1 (A)
unnamed: D1.7.2 (A), SW1.7.1 (A)
unnamed: D1.8.2 (A), SW1.8.1 (A)
unnamed: D2.0.2 (A), SW2.0.1 (A)
unnamed: D2.1.2 (A), SW2.1.1 (A)
unnamed: D2.2.2 (A), SW2.2.1 (A)
unnamed: D2.3.2 (A), SW2.3.1 (A)
unnamed: D2.4.2 (A), SW2.4.1 (A)
unnamed: D2.5.2 (A), SW2.5.1 (A)
unnamed: D2.6.2 (A), SW2.6.1 (A)
unnamed: D2.7.2 (A), SW2.7.1 (A)
arduino_D2: Conn1.3, SW.PushPull.1.2 (B)
arduino_D3: Conn1.5, D1.1.1 (K), D1.2.1 (K), D1.3.1 (K), D1.4.1 (K), D1.5.1 (K), D1.6.1 (K), D1.7.1 (K), D1.8.1 (K), R1.1
arduino_D4: Conn1.7, D2.0.1 (K), D2.1.1 (K), D2.2.1 (K), D2.3.1 (K), D2.4.1 (K), D2.5.1 (K), D2.6.1 (K), D2.7.1 (K), R2.1
arduino_D5: Conn1.9, SW1.1.2 (B), SW2.0.2 (B)
arduino_D6: Conn1.11, SW1.2.2 (B), SW2.1.2 (B)
arduino_D7: Conn1.13, SW1.3.2 (B), SW2.2.2 (B)
arduino_D8: Conn1.15, SW1.4.2 (B), SW2.3.2 (B)
arduino_D9: Conn1.17, SW1.5.2 (B), SW2.4.2 (B)
arduino_D10: Conn1.19, SW1.6.2 (B), SW2.5.2 (B)
arduino_D11: Conn1.21, SW1.7.2 (B), SW2.6.2 (B)
arduino_D12: Conn1.23, SW1.8.2 (B), SW2.7.2 (B)

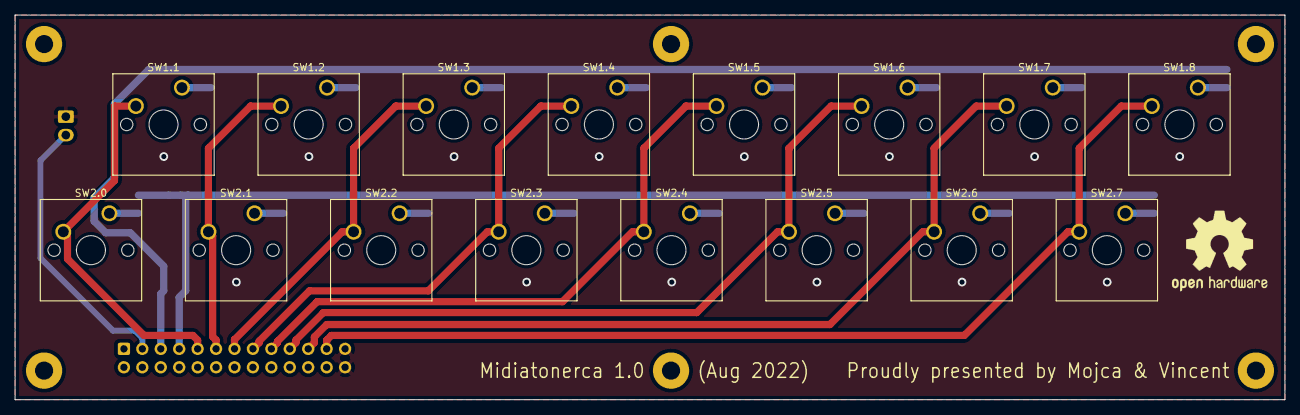
[picture p37: board cherry-basses.kicad_pcb from above]

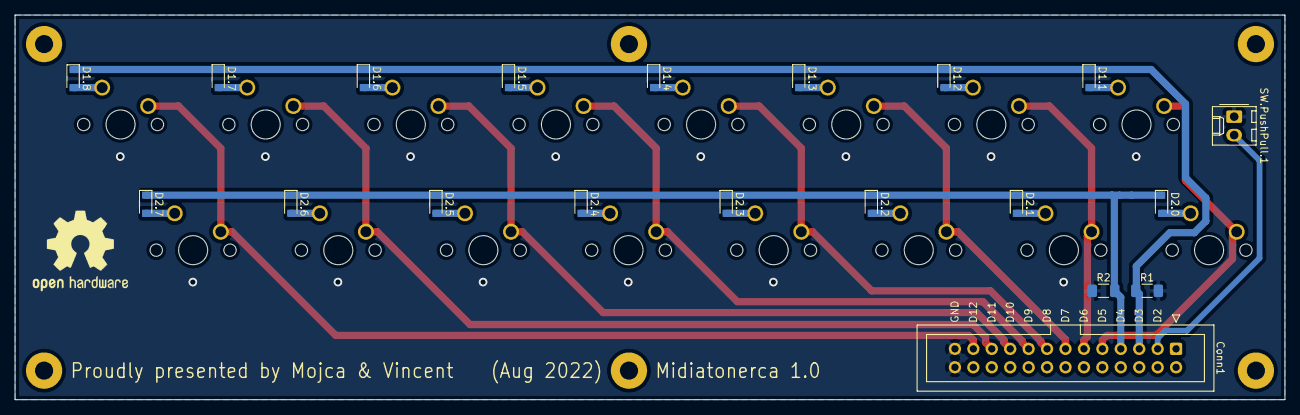
[picture p38: board cherry-basses.kicad_pcb from below]

Board: 2 copper layers, 175.0 x 53.0 mm, 36 parts (20 on the bottom side), 28 nets.
