mojca/midiatonerca/kicad/optocouplers-rewire/optocouplers.kicad_pcb

## KiCad design kicad/optocouplers-rewire/optocouplers.kicad_pcb (2024-03-04)

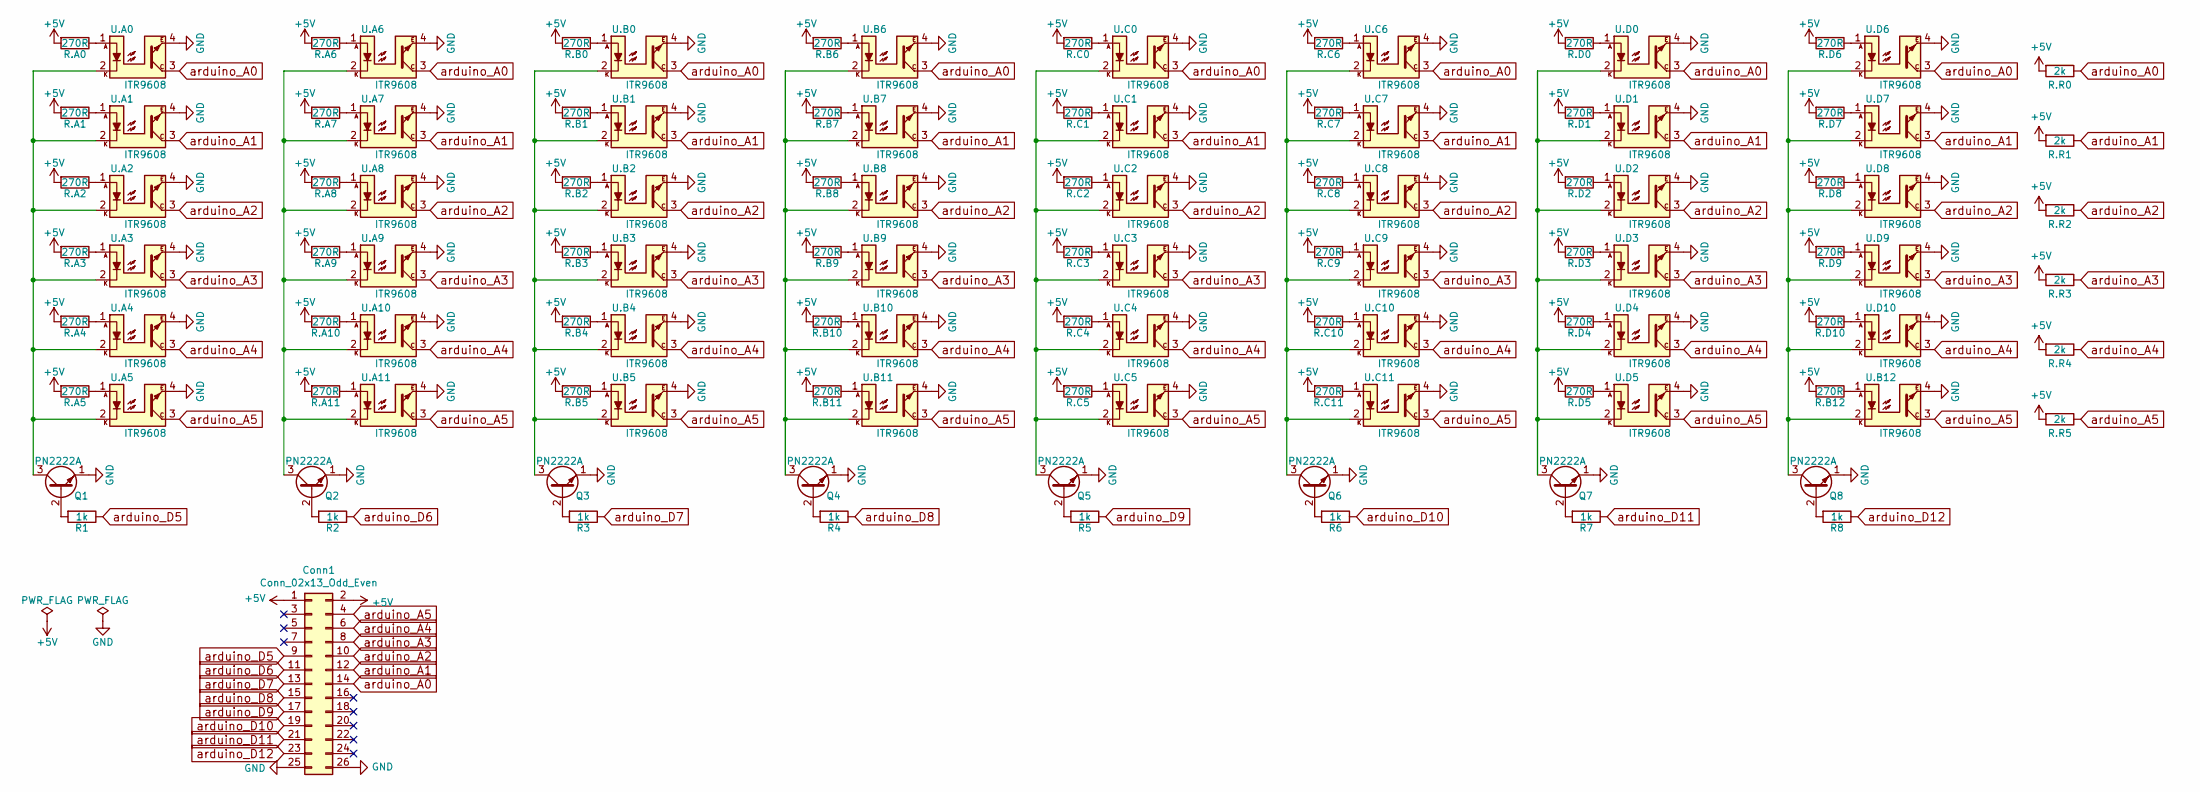
[picture p39: schematic optocouplers.kicad_sch]

Parts:
Conn1: Conn_02x13_Odd_Even; IDC-Header_2x13_P2.54mm_Vertical; LCSC Part # C692426
Q1, Q2, Q3, Q4, Q5, Q6, Q7, Q8: PN2222A; TO-92_Inline_Wide; LCSC Part # C184875
R1, R2, R3, R4, R5, R6, R7, R8: 1k; R_1206_3216Metric_Pad1.30x1.75mm_HandSolder; LCSC Part # C4410
R.A0, R.A1, R.A2, R.A3, R.A4, R.A5, R.A6, R.A7, R.A8, R.A9, R.A10, R.A11, R.B0, R.B1, R.B2, R.B3, R.B4, R.B5, R.B6, R.B7, R.B8, R.B9, R.B10, R.B11, R.B12, R.C0, R.C1, R.C2, R.C3, R.C4, R.C5, R.C6, R.C7, R.C8, R.C9, R.C10, R.C11, R.D0, R.D1, R.D2, R.D3, R.D4, R.D5, R.D6, R.D7, R.D8, R.D9, R.D10: 270R; R_1206_3216Metric_Pad1.30x1.75mm_HandSolder; LCSC Part # C229488
R.R0, R.R1, R.R2, R.R3, R.R4, R.R5: 2k; R_1206_3216Metric_Pad1.30x1.75mm_HandSolder; LCSC Part # C17944
U.A0, U.A1, U.A2, U.A3, U.A4, U.A5, U.A6, U.A7, U.A8, U.A9, U.A10, U.A11, U.B0, U.B1, U.B2, U.B3, U.B4, U.B5, U.B6, U.B7, U.B8, U.B9, U.B10, U.B11, U.B12, U.C0, U.C1, U.C2, U.C3, U.C4, U.C5, U.C6, U.C7, U.C8, U.C9, U.C10, U.C11, U.D0, U.D1, U.D2, U.D3, U.D4, U.D5, U.D6, U.D7, U.D8, U.D9, U.D10: ITR9608; LCSC Part # C52833

Connections:
+5V: Conn1.1, Conn1.2, R.A0.2, R.A1.2, R.A2.2, R.A3.2, R.A4.2, R.A5.2, R.A6.2, R.A7.2, R.A8.2, R.A9.2, R.A10.2, R.A11.2, R.B0.2, R.B1.2, R.B2.2, R.B3.2, R.B4.2, R.B5.2, R.B6.2, R.B7.2, R.B8.2, R.B9.2, R.B10.2, R.B11.2, R.B12.2, R.C0.2, R.C1.2, R.C2.2, R.C3.2, R.C4.2, R.C5.2, R.C6.2, R.C7.2, R.C8.2, R.C9.2, R.C10.2, R.C11.2, R.D0.2, R.D1.2, R.D2.2, R.D3.2, R.D4.2, R.D5.2, R.D6.2, R.D7.2, R.D8.2, R.D9.2, R.D10.2, R.R0.2, R.R1.2, R.R2.2, R.R3.2, R.R4.2, R.R5.2
GND: Conn1.25, Conn1.26, Q1.1 (E), Q2.1 (E), Q3.1 (E), Q4.1 (E), Q5.1 (E), Q6.1 (E), Q7.1 (E), Q8.1 (E), U.A0.4, U.A1.4, U.A2.4, U.A3.4, U.A4.4, U.A5.4, U.A6.4, U.A7.4, U.A8.4, U.A9.4, U.A10.4, U.A11.4, U.B0.4, U.B1.4, U.B2.4, U.B3.4, U.B4.4, U.B5.4, U.B6.4, U.B7.4, U.B8.4, U.B9.4, U.B10.4, U.B11.4, U.B12.4, U.C0.4, U.C1.4, U.C2.4, U.C3.4, U.C4.4, U.C5.4, U.C6.4, U.C7.4, U.C8.4, U.C9.4, U.C10.4, U.C11.4, U.D0.4, U.D1.4, U.D2.4, U.D3.4, U.D4.4, U.D5.4, U.D6.4, U.D7.4, U.D8.4, U.D9.4, U.D10.4
unnamed: Q1.2 (B), R1.2
unnamed: Q1.3 (C), U.A0.2, U.A1.2, U.A2.2, U.A3.2, U.A4.2, U.A5.2
unnamed: Q2.2 (B), R2.2
unnamed: Q2.3 (C), U.A6.2, U.A7.2, U.A8.2, U.A9.2, U.A10.2, U.A11.2
unnamed: Q3.2 (B), R3.2
unnamed: Q3.3 (C), U.B0.2, U.B1.2, U.B2.2, U.B3.2, U.B4.2, U.B5.2
unnamed: Q4.2 (B), R4.2
unnamed: Q4.3 (C), U.B6.2, U.B7.2, U.B8.2, U.B9.2, U.B10.2, U.B11.2
unnamed: Q5.2 (B), R5.2
unnamed: Q5.3 (C), U.C0.2, U.C1.2, U.C2.2, U.C3.2, U.C4.2, U.C5.2
unnamed: Q6.2 (B), R6.2
unnamed: Q6.3 (C), U.C6.2, U.C7.2, U.C8.2, U.C9.2, U.C10.2, U.C11.2
unnamed: Q7.2 (B), R7.2
unnamed: Q7.3 (C), U.D0.2, U.D1.2, U.D2.2, U.D3.2, U.D4.2, U.D5.2
unnamed: Q8.2 (B), R8.2
unnamed: Q8.3 (C), U.B12.2, U.D6.2, U.D7.2, U.D8.2, U.D9.2, U.D10.2
unnamed: R.A0.1, U.A0.1
unnamed: R.A1.1, U.A1.1
unnamed: R.A2.1, U.A2.1
unnamed: R.A3.1, U.A3.1
unnamed: R.A4.1, U.A4.1
unnamed: R.A5.1, U.A5.1
unnamed: R.A6.1, U.A6.1
unnamed: R.A7.1, U.A7.1
unnamed: R.A8.1, U.A8.1
unnamed: R.A9.1, U.A9.1
unnamed: R.A10.1, U.A10.1
unnamed: R.A11.1, U.A11.1
unnamed: R.B0.1, U.B0.1
unnamed: R.B1.1, U.B1.1
unnamed: R.B2.1, U.B2.1
unnamed: R.B3.1, U.B3.1
unnamed: R.B4.1, U.B4.1
unnamed: R.B5.1, U.B5.1
unnamed: R.B6.1, U.B6.1
unnamed: R.B7.1, U.B7.1
unnamed: R.B8.1, U.B8.1
unnamed: R.B9.1, U.B9.1
unnamed: R.B10.1, U.B10.1
unnamed: R.B11.1, U.B11.1
unnamed: R.B12.1, U.B12.1
unnamed: R.C0.1, U.C0.1
unnamed: R.C1.1, U.C1.1
unnamed: R.C2.1, U.C2.1
unnamed: R.C3.1, U.C3.1
unnamed: R.C4.1, U.C4.1
unnamed: R.C5.1, U.C5.1
unnamed: R.C6.1, U.C6.1
unnamed: R.C7.1, U.C7.1
unnamed: R.C8.1, U.C8.1
unnamed: R.C9.1, U.C9.1
unnamed: R.C10.1, U.C10.1
unnamed: R.C11.1, U.C11.1
unnamed: R.D0.1, U.D0.1
unnamed: R.D1.1, U.D1.1
unnamed: R.D2.1, U.D2.1
unnamed: R.D3.1, U.D3.1
unnamed: R.D4.1, U.D4.1
unnamed: R.D5.1, U.D5.1
unnamed: R.D6.1, U.D6.1
unnamed: R.D7.1, U.D7.1
unnamed: R.D8.1, U.D8.1
unnamed: R.D9.1, U.D9.1
unnamed: R.D10.1, U.D10.1
arduino_A0: Conn1.14, R.R0.1, U.A0.3, U.A6.3, U.B0.3, U.B6.3, U.C0.3, U.C6.3, U.D0.3, U.D6.3
arduino_A1: Conn1.12, R.R1.1, U.A1.3, U.A7.3, U.B1.3, U.B7.3, U.C1.3, U.C7.3, U.D1.3, U.D7.3
arduino_A2: Conn1.10, R.R2.1, U.A2.3, U.A8.3, U.B2.3, U.B8.3, U.C2.3, U.C8.3, U.D2.3, U.D8.3
arduino_A3: Conn1.8, R.R3.1, U.A3.3, U.A9.3, U.B3.3, U.B9.3, U.C3.3, U.C9.3, U.D3.3, U.D9.3
arduino_A4: Conn1.6, R.R4.1, U.A4.3, U.A10.3, U.B4.3, U.B10.3, U.C4.3, U.C10.3, U.D4.3, U.D10.3
arduino_A5: Conn1.4, R.R5.1, U.A5.3, U.A11.3, U.B5.3, U.B11.3, U.B12.3, U.C5.3, U.C11.3, U.D5.3
arduino_D5: Conn1.9, R1.1
arduino_D6: Conn1.11, R2.1
arduino_D7: Conn1.13, R3.1
arduino_D8: Conn1.15, R4.1
arduino_D9: Conn1.17, R5.1
arduino_D10: Conn1.19, R6.1
arduino_D11: Conn1.21, R7.1
arduino_D12: Conn1.23, R8.1

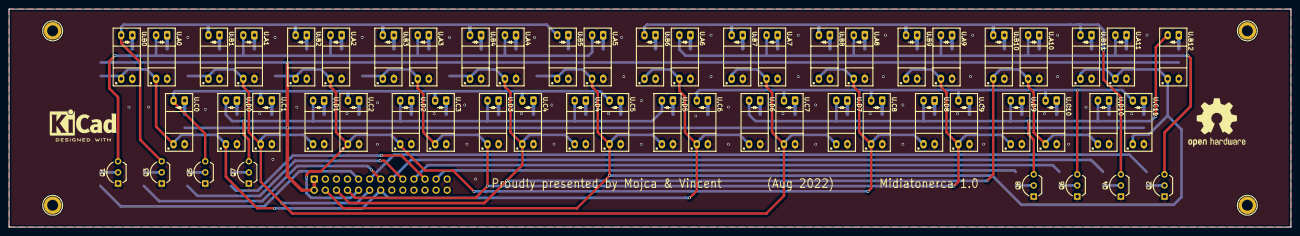
[picture p40: board optocouplers.kicad_pcb from above]

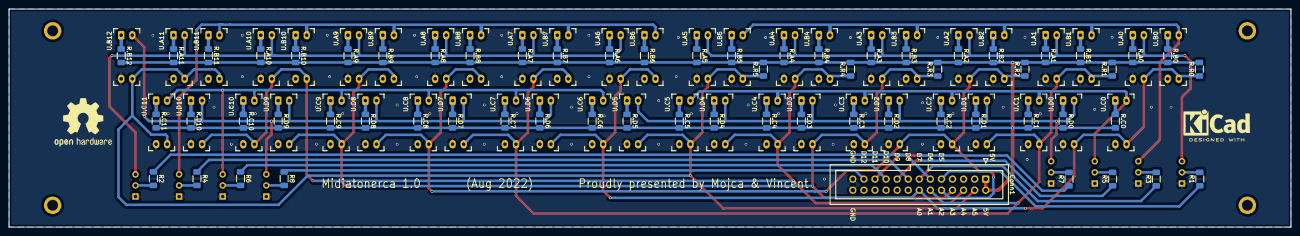
[picture p41: board optocouplers.kicad_pcb from below]

Board: 2 copper layers, 294.0 x 50.0 mm, 119 parts (63 on the bottom side), 80 nets.
