mojca/midiatonerca/kicad/cherry-treble/cherry-treble.kicad_pcb

## KiCad design kicad/cherry-treble/cherry-treble.kicad_pcb (2024-03-04)

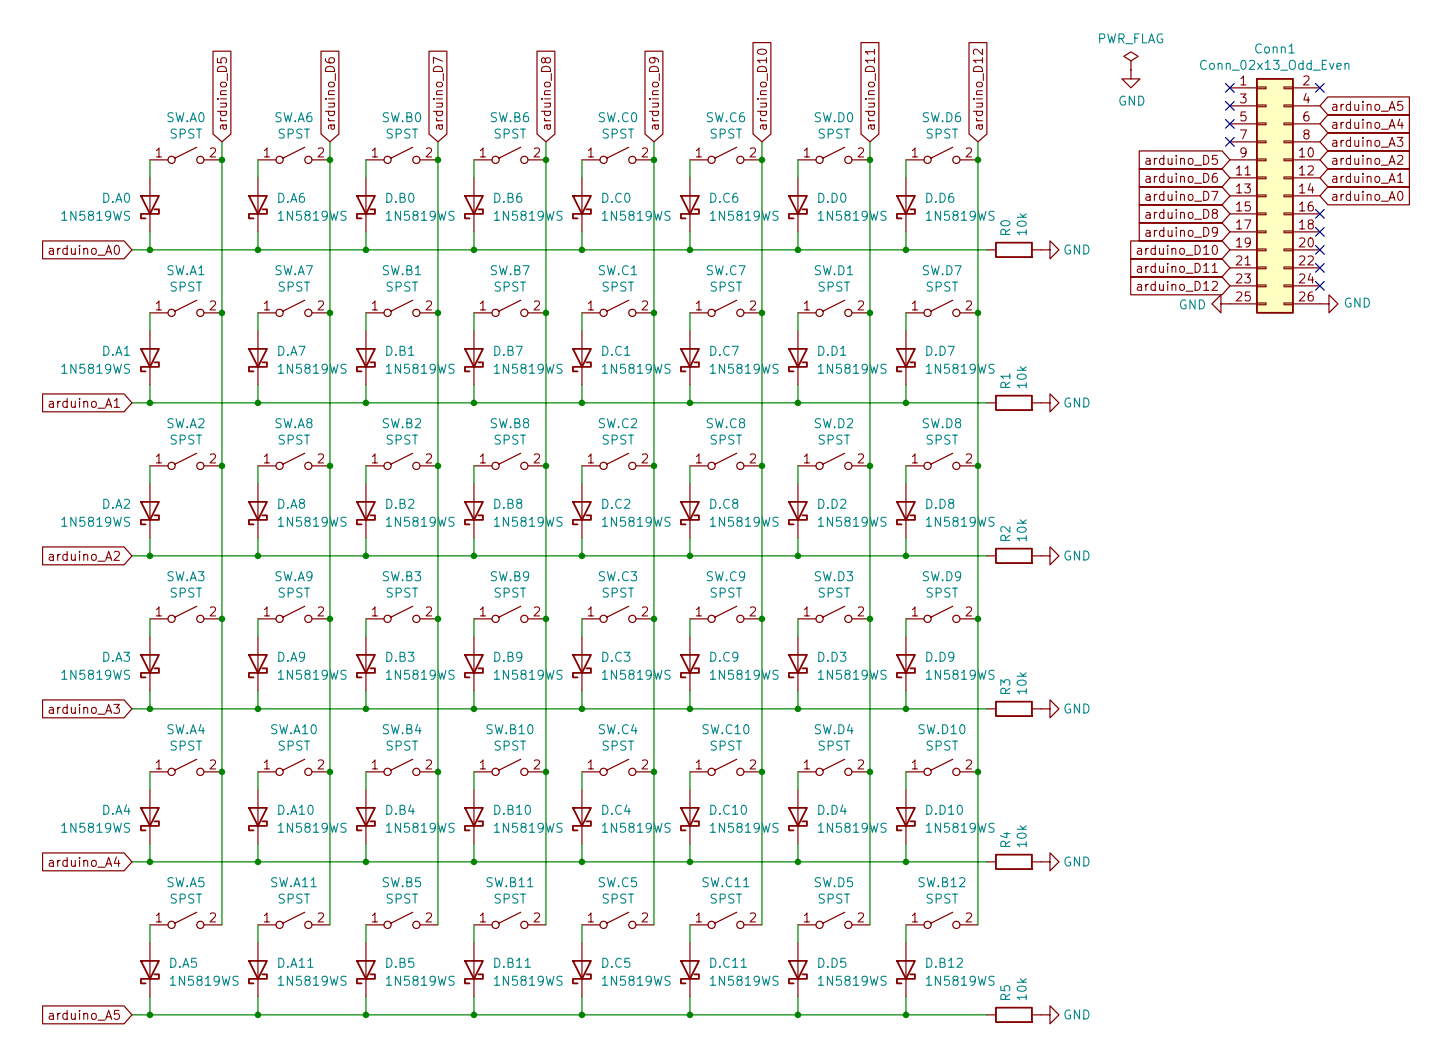
[picture p42: schematic cherry-treble.kicad_sch]

Parts:
Conn1: Conn_02x13_Odd_Even; IDC-Header_2x13_P2.54mm_Vertical
D.A0, D.A1, D.A2, D.A3, D.A4, D.A5, D.A6, D.A7, D.A8, D.A9, D.A10, D.A11, D.B0, D.B1, D.B2, D.B3, D.B4, D.B5, D.B6, D.B7, D.B8, D.B9, D.B10, D.B11, D.B12, D.C0, D.C1, D.C2, D.C3, D.C4, D.C5, D.C6, D.C7, D.C8, D.C9, D.C10, D.C11, D.D0, D.D1, D.D2, D.D3, D.D4, D.D5, D.D6, D.D7, D.D8, D.D9, D.D10: 1N5819WS; D_SOD-323_HandSoldering; LCSC Part # C2128
R0, R1, R2, R3, R4, R5: 10k; R_1206_3216Metric_Pad1.30x1.75mm_HandSolder; LCSC Part # C17902
SW.A0, SW.A1, SW.A2, SW.A3, SW.A4, SW.A5, SW.A6, SW.A7, SW.A8, SW.A9, SW.A10, SW.A11, SW.B0, SW.B1, SW.B2, SW.B3, SW.B4, SW.B5, SW.B6, SW.B7, SW.B8, SW.B9, SW.B10, SW.B11, SW.B12, SW.C0, SW.C1, SW.C2, SW.C3, SW.C4, SW.C5, SW.C6, SW.C7, SW.C8, SW.C9, SW.C10, SW.C11, SW.D0, SW.D1, SW.D2, SW.D3, SW.D4, SW.D5, SW.D6, SW.D7, SW.D8, SW.D9, SW.D10: SPST; SW_Cherry_MX_1.00u_PCB

Connections:
GND: Conn1.25, Conn1.26, R0.2, R1.2, R2.2, R3.2, R4.2, R5.2
unnamed: D.A0.2 (A), SW.A0.1 (A)
unnamed: D.A1.2 (A), SW.A1.1 (A)
unnamed: D.A2.2 (A), SW.A2.1 (A)
unnamed: D.A3.2 (A), SW.A3.1 (A)
unnamed: D.A4.2 (A), SW.A4.1 (A)
unnamed: D.A5.2 (A), SW.A5.1 (A)
unnamed: D.A6.2 (A), SW.A6.1 (A)
unnamed: D.A7.2 (A), SW.A7.1 (A)
unnamed: D.A8.2 (A), SW.A8.1 (A)
unnamed: D.A9.2 (A), SW.A9.1 (A)
unnamed: D.A10.2 (A), SW.A10.1 (A)
unnamed: D.A11.2 (A), SW.A11.1 (A)
unnamed: D.B0.2 (A), SW.B0.1 (A)
unnamed: D.B1.2 (A), SW.B1.1 (A)
unnamed: D.B2.2 (A), SW.B2.1 (A)
unnamed: D.B3.2 (A), SW.B3.1 (A)
unnamed: D.B4.2 (A), SW.B4.1 (A)
unnamed: D.B5.2 (A), SW.B5.1 (A)
unnamed: D.B6.2 (A), SW.B6.1 (A)
unnamed: D.B7.2 (A), SW.B7.1 (A)
unnamed: D.B8.2 (A), SW.B8.1 (A)
unnamed: D.B9.2 (A), SW.B9.1 (A)
unnamed: D.B10.2 (A), SW.B10.1 (A)
unnamed: D.B11.2 (A), SW.B11.1 (A)
unnamed: D.B12.2 (A), SW.B12.1 (A)
unnamed: D.C0.2 (A), SW.C0.1 (A)
unnamed: D.C1.2 (A), SW.C1.1 (A)
unnamed: D.C2.2 (A), SW.C2.1 (A)
unnamed: D.C3.2 (A), SW.C3.1 (A)
unnamed: D.C4.2 (A), SW.C4.1 (A)
unnamed: D.C5.2 (A), SW.C5.1 (A)
unnamed: D.C6.2 (A), SW.C6.1 (A)
unnamed: D.C7.2 (A), SW.C7.1 (A)
unnamed: D.C8.2 (A), SW.C8.1 (A)
unnamed: D.C9.2 (A), SW.C9.1 (A)
unnamed: D.C10.2 (A), SW.C10.1 (A)
unnamed: D.C11.2 (A), SW.C11.1 (A)
unnamed: D.D0.2 (A), SW.D0.1 (A)
unnamed: D.D1.2 (A), SW.D1.1 (A)
unnamed: D.D2.2 (A), SW.D2.1 (A)
unnamed: D.D3.2 (A), SW.D3.1 (A)
unnamed: D.D4.2 (A), SW.D4.1 (A)
unnamed: D.D5.2 (A), SW.D5.1 (A)
unnamed: D.D6.2 (A), SW.D6.1 (A)
unnamed: D.D7.2 (A), SW.D7.1 (A)
unnamed: D.D8.2 (A), SW.D8.1 (A)
unnamed: D.D9.2 (A), SW.D9.1 (A)
unnamed: D.D10.2 (A), SW.D10.1 (A)
arduino_A0: Conn1.14, D.A0.1 (K), D.A6.1 (K), D.B0.1 (K), D.B6.1 (K), D.C0.1 (K), D.C6.1 (K), D.D0.1 (K), D.D6.1 (K), R0.1
arduino_A1: Conn1.12, D.A1.1 (K), D.A7.1 (K), D.B1.1 (K), D.B7.1 (K), D.C1.1 (K), D.C7.1 (K), D.D1.1 (K), D.D7.1 (K), R1.1
arduino_A2: Conn1.10, D.A2.1 (K), D.A8.1 (K), D.B2.1 (K), D.B8.1 (K), D.C2.1 (K), D.C8.1 (K), D.D2.1 (K), D.D8.1 (K), R2.1
arduino_A3: Conn1.8, D.A3.1 (K), D.A9.1 (K), D.B3.1 (K), D.B9.1 (K), D.C3.1 (K), D.C9.1 (K), D.D3.1 (K), D.D9.1 (K), R3.1
arduino_A4: Conn1.6, D.A4.1 (K), D.A10.1 (K), D.B4.1 (K), D.B10.1 (K), D.C4.1 (K), D.C10.1 (K), D.D4.1 (K), D.D10.1 (K), R4.1
arduino_A5: Conn1.4, D.A5.1 (K), D.A11.1 (K), D.B5.1 (K), D.B11.1 (K), D.B12.1 (K), D.C5.1 (K), D.C11.1 (K), D.D5.1 (K), R5.1
arduino_D5: Conn1.9, SW.A0.2 (B), SW.A1.2 (B), SW.A2.2 (B), SW.A3.2 (B), SW.A4.2 (B), SW.A5.2 (B)
arduino_D6: Conn1.11, SW.A6.2 (B), SW.A7.2 (B), SW.A8.2 (B), SW.A9.2 (B), SW.A10.2 (B), SW.A11.2 (B)
arduino_D7: Conn1.13, SW.B0.2 (B), SW.B1.2 (B), SW.B2.2 (B), SW.B3.2 (B), SW.B4.2 (B), SW.B5.2 (B)
arduino_D8: Conn1.15, SW.B6.2 (B), SW.B7.2 (B), SW.B8.2 (B), SW.B9.2 (B), SW.B10.2 (B), SW.B11.2 (B)
arduino_D9: Conn1.17, SW.C0.2 (B), SW.C1.2 (B), SW.C2.2 (B), SW.C3.2 (B), SW.C4.2 (B), SW.C5.2 (B)
arduino_D10: Conn1.19, SW.C6.2 (B), SW.C7.2 (B), SW.C8.2 (B), SW.C9.2 (B), SW.C10.2 (B), SW.C11.2 (B)
arduino_D11: Conn1.21, SW.D0.2 (B), SW.D1.2 (B), SW.D2.2 (B), SW.D3.2 (B), SW.D4.2 (B), SW.D5.2 (B)
arduino_D12: Conn1.23, SW.B12.2 (B), SW.D6.2 (B), SW.D7.2 (B), SW.D8.2 (B), SW.D9.2 (B), SW.D10.2 (B)

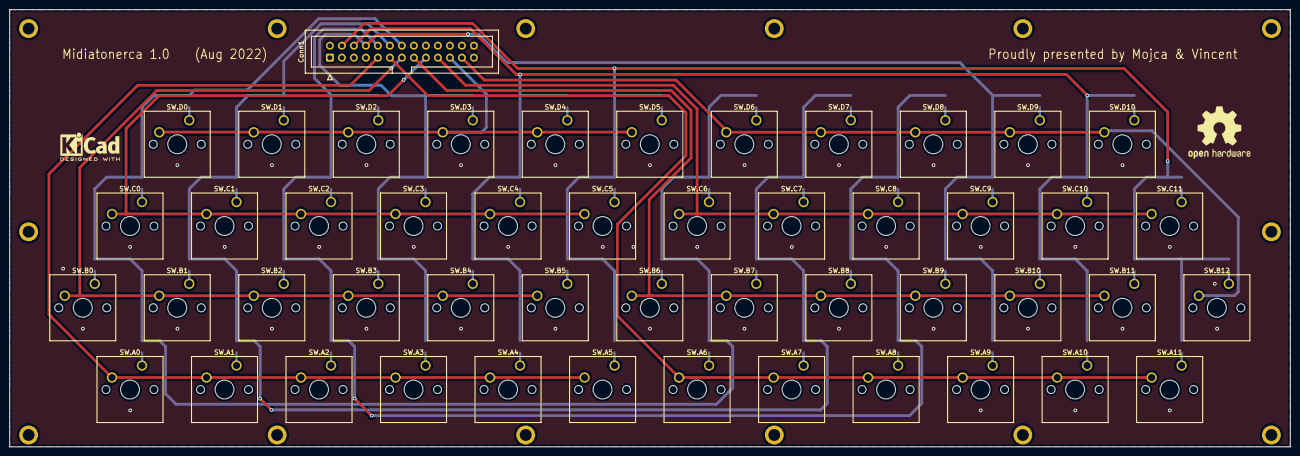
[picture p43: board cherry-treble.kicad_pcb from above]

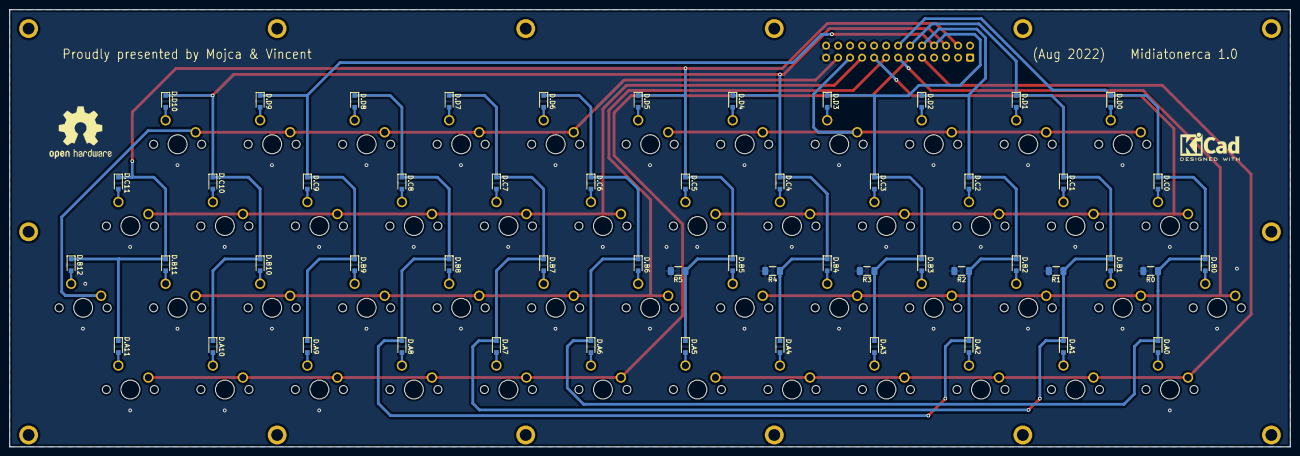
[picture p44: board cherry-treble.kicad_pcb from below]

Board: 2 copper layers, 271.0 x 92.5 mm, 103 parts (54 on the bottom side), 63 nets.
