mojca/midiatonerca/kicad/keyboard-with-pushbuttons-and-leds/keyboard.kicad_pcb

## KiCad design kicad/keyboard-with-pushbuttons-and-leds/keyboard.kicad_pcb (2017-08-04)

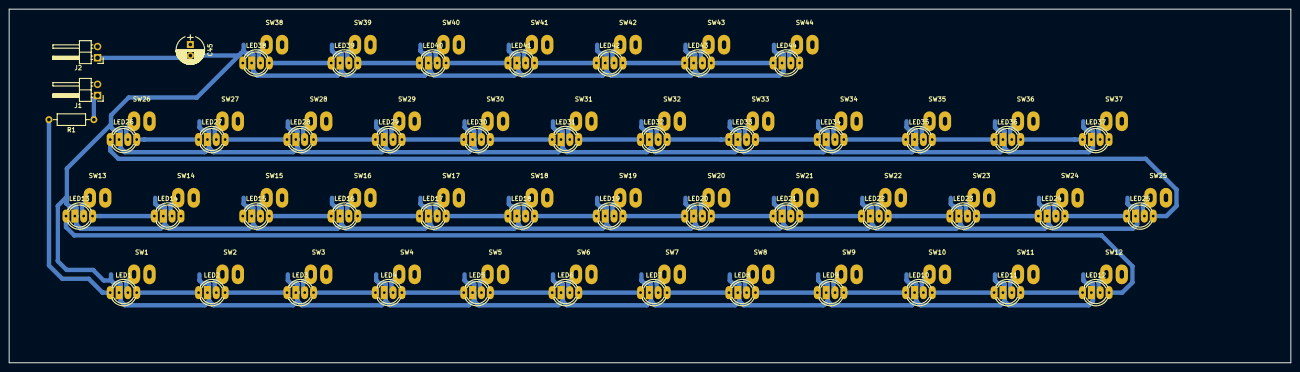
[picture p45: board keyboard.kicad_pcb from above]

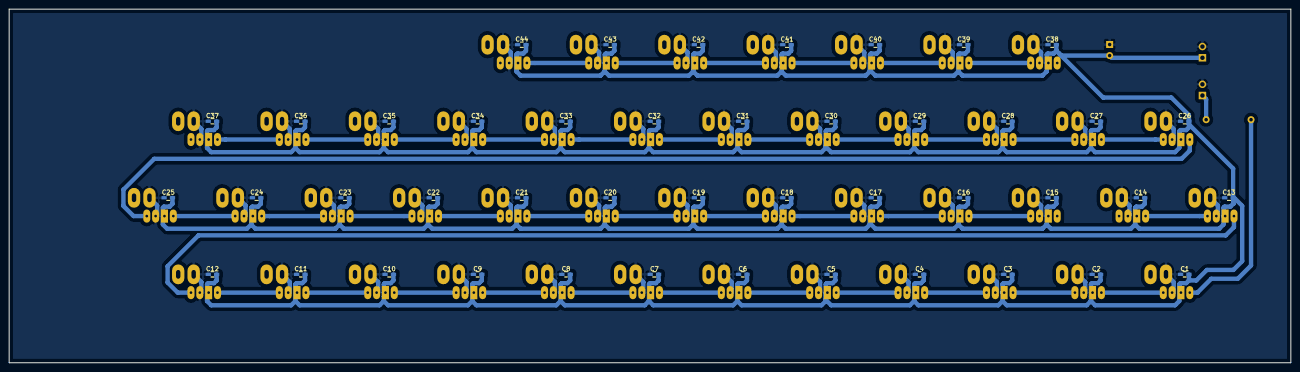
[picture p46: board keyboard.kicad_pcb from below]

Board: 2 copper layers, 290.0 x 80.0 mm, 136 parts (44 on the bottom side), 47 nets.

Parts:
C1, C2, C3, C4, C5, C6, C7, C8, C9, C10, C11, C12, C13, C14, C15, C16, C17, C18, C19, C20, C21, C22, C23, C24, C25, C26, C27, C28, C29, C30, C31, C32, C33, C34, C35, C36, C37, C38, C39, C40, C41, C42, C43, C44: C; C_0603_HandSoldering
C45: 1000uF; CP_Radial_D6.3mm_P2.50mm
J1, J2: CONN_01X02_MALE; Pin_Header_Angled_1x02_Pitch2.54mm
LED1, LED2, LED3, LED4, LED5, LED6, LED7, LED8, LED9, LED10, LED11, LED12, LED13, LED14, LED15, LED16, LED17, LED18, LED19, LED20, LED21, LED22, LED23, LED24, LED25, LED26, LED27, LED28, LED29, LED30, LED31, LED32, LED33, LED34, LED35, LED36, LED37, LED38, LED39, LED40, LED41, LED42, LED43, LED44: WS2812B; LED_D5.0mm-4-2mm
R1: 270R; R_Axial_DIN0207_L6.3mm_D2.5mm_P10.16mm_Horizontal
SW1, SW2, SW3, SW4, SW5, SW6, SW7, SW8, SW9, SW10, SW11, SW12, SW13, SW14, SW15, SW16, SW17, SW18, SW19, SW20, SW21, SW22, SW23, SW24, SW25, SW26, SW27, SW28, SW29, SW30, SW31, SW32, SW33, SW34, SW35, SW36, SW37, SW38, SW39, SW40, SW41, SW42, SW43, SW44: SW_Push; SW_PUSH_6mm

Connections:
GND: C1.1, C2.1, C3.1, C4.1, C5.1, C6.1, C7.1, C8.1, C9.1, C10.1, C11.1, C12.1, C13.1, C14.1, C15.1, C16.1, C17.1, C18.1, C19.1, C20.1, C21.1, C22.1, C23.1, C24.1, C25.1, C26.1, C27.1, C28.1, C29.1, C30.1, C31.1, C32.1, C33.1, C34.1, C35.1, C36.1, C37.1, C38.1, C39.1, C40.1, C41.1, C42.1, C43.1, C44.1, C45.1, J1.2, J2.2, LED1.3, LED2.3, LED3.3, LED4.3, LED5.3, LED6.3, LED7.3, LED8.3, LED9.3, LED10.3, LED11.3, LED12.3, LED13.3, LED14.3, LED15.3, LED16.3, LED17.3, LED18.3, LED19.3, LED20.3, LED21.3, LED22.3, LED23.3, LED24.3, LED25.3, LED26.3, LED27.3, LED28.3, LED29.3, LED30.3, LED31.3, LED32.3, LED33.3, LED34.3, LED35.3, LED36.3, LED37.3, LED38.3, LED39.3, LED40.3, LED41.3, LED42.3, LED43.3, LED44.3, SW1.1, SW2.1, SW3.1, SW4.1, SW5.1, SW6.1, SW7.1, SW8.1, SW9.1, SW10.1, SW11.1, SW12.1, SW13.1, SW14.1, SW15.1, SW16.1, SW17.1, SW18.1, SW19.1, SW20.1, SW21.1, SW22.1, SW23.1, SW24.1, SW25.1, SW26.1, SW27.1, SW28.1, SW29.1, SW30.1, SW31.1, SW32.1, SW33.1, SW34.1, SW35.1, SW36.1, SW37.1, SW38.1, SW39.1, SW40.1, SW41.1, SW42.1, SW43.1, SW44.1
unnamed: J1.1, R1.1
unnamed: LED1.2, LED2.4
unnamed: LED1.4, R1.2
unnamed: LED2.2, LED3.4
unnamed: LED3.2, LED4.4
unnamed: LED4.2, LED5.4
unnamed: LED5.2, LED6.4
unnamed: LED6.2, LED7.4
unnamed: LED7.2, LED8.4
unnamed: LED8.2, LED9.4
unnamed: LED10.2, LED11.4
unnamed: LED9.2, LED10.4
unnamed: LED11.2, LED12.4
unnamed: LED12.2, LED13.4
unnamed: LED13.2, LED14.4
unnamed: LED14.2, LED15.4
unnamed: LED15.2, LED16.4
unnamed: LED16.2, LED17.4
unnamed: LED17.2, LED18.4
unnamed: LED18.2, LED19.4
unnamed: LED19.2, LED20.4
unnamed: LED20.2, LED21.4
unnamed: LED21.2, LED22.4
unnamed: LED22.2, LED23.4
unnamed: LED23.2, LED24.4
unnamed: LED24.2, LED25.4
unnamed: LED25.2, LED26.4
unnamed: LED26.2, LED27.4
unnamed: LED27.2, LED28.4
unnamed: LED28.2, LED29.4
unnamed: LED29.2, LED30.4
unnamed: LED30.2, LED31.4
unnamed: LED31.2, LED32.4
unnamed: LED32.2, LED33.4
unnamed: LED33.2, LED34.4
unnamed: LED34.2, LED35.4
unnamed: LED35.2, LED36.4
unnamed: LED36.2, LED37.4
unnamed: LED37.2, LED38.4
unnamed: LED38.2, LED39.4
unnamed: LED39.2, LED40.4
unnamed: LED40.2, LED41.4
unnamed: LED41.2, LED42.4
unnamed: LED42.2, LED43.4
unnamed: LED43.2, LED44.4
VccLed: C1.2, C2.2, C3.2, C4.2, C5.2, C6.2, C7.2, C8.2, C9.2, C10.2, C11.2, C12.2, C13.2, C14.2, C15.2, C16.2, C17.2, C18.2, C19.2, C20.2, C21.2, C22.2, C23.2, C24.2, C25.2, C26.2, C27.2, C28.2, C29.2, C30.2, C31.2, C32.2, C33.2, C34.2, C35.2, C36.2, C37.2, C38.2, C39.2, C40.2, C41.2, C42.2, C43.2, C44.2, C45.2, J2.1, LED1.1, LED2.1, LED3.1, LED4.1, LED5.1, LED6.1, LED7.1, LED8.1, LED9.1, LED10.1, LED11.1, LED12.1, LED13.1, LED14.1, LED15.1, LED16.1, LED17.1, LED18.1, LED19.1, LED20.1, LED21.1, LED22.1, LED23.1, LED24.1, LED25.1, LED26.1, LED27.1, LED28.1, LED29.1, LED30.1, LED31.1, LED32.1, LED33.1, LED34.1, LED35.1, LED36.1, LED37.1, LED38.1, LED39.1, LED40.1, LED41.1, LED42.1, LED43.1, LED44.1
