mojca/midiatonerca/(commit log)

2017-07-24 revision 3 and 4 of 3D design
    [DummyLever3v3.dxf, KeyboardPlatev3.dxf, Lever1f.dxf, Lever1v3.dxf, Lever2f.dxf, Lever2v3.dxf, Lever3f_3mm.dxf, Lever4f.dxf]
2017-07-24 alternative keyboard plates
2017-07-24 dxf files for keyboards
    [keyboard-holes-for-switches-only-1.dxf, keyboard-holes-for-switches-only-2.dxf, keyboard-holes-for-switches-only-3.dxf]
2017-07-26 test dxf conversion from pstoedit
    [keyboard-holes-for-switches-only-1a.dxf]
2017-07-26 test dxf
    [Lever1vH.dxf]
2017-07-26 add dxf files for revision 5
    [FullPlate_53x42_3mm_lever3_32pieces.dxf, FullPlate_68x40_4mm_frame_aligners.dxf, FullPlate_68x40_4mm_interrupter_omegaholder_lever1_sparelevers.dxf, FullPlate_68x52_4mm_lever2_4_5.dxf, HalfPlate_64x50_4mm_SideCovers_2x.dxf, Lever1vH.dxf]
2017-07-26 add zips
    [BackPlateH.dxf, BottomPlateH.dxf, CoverPlateH.dxf, DummyLever3vH.dxf, FrontPlateH.dxf, InterrupterBoardH.dxf, KeyboardPlateH.dxf, Lever1vH.dxf]
2017-07-26 revision 6
    [BackPlateH.DXF, BottomPlateH.DXF, CoverPlateH.DXF, DummyLever3vH.DXF, FrontPlateH.DXF, FullPlate_53x42_3mm_lever3_32pieces.dxf, FullPlate_68x40_4mm_frame_aligners.dxf, FullPlate_68x40_4mm_interrupter_omegaholder_lever1_sparelevers.dxf]
2017-07-27 alt keyboard
    [keyboard-holes-for-switches-only-2.dxf, keyboard-holes-for-switches-only-3.dxf]
2017-07-28 optocoupler board
    [optocoupler-board.dxf]
2017-07-31 testing design for the keyboard
    [keyboard.kicad_pcb, keyboard.sch]
2017-07-31 Added schematic for octocoupler backplate
    [accordion.kicad_pcb, accordion.sch]
2017-07-31 start creating a pattern
    [keyboard.kicad_pcb, keyboard.sch]
2017-07-31 keyboard pcb: two lines
    [keyboard.kicad_pcb, keyboard.sch]
2017-07-31 full board for keyboard
    [keyboard.kicad_pcb]
2017-08-01 nearly final version of keyboard PCB
    [keyboard.kicad_pcb]
2017-08-02 Arduino code for LeverHarmonica added
2017-08-03 Single button MIDI latency tester
2017-08-04 version of printed pcb
    [keyboard.kicad_pcb, keyboard.sch]
2017-08-05 Fix debounce on second accordion
    [LeverHarmonica2.ino]
2019-09-15 Added Arduino project: BassButtonTester. Actually also for testing treble buttons. Different pin assignments can be configured. Analog sensor readings can be inspected, as well as single row/column d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
    BassButton is a class which makes it easy to embed it in different projects and hide the complexity of the implementation.
2022-07-28 Specify buttons with names
2022-07-28 Add an optional test routine which is run if a flag is set
    The test routine continuously produces one simple note.
    Baudrate changed to 115200, to avoid the 31250/38400 bug in SamplerBox.
    Some more corrections and changes and updates.
    [LeverHarmonica.ino]
2022-07-29 Added support to count the number of buttons playing the same note.
    Multiple buttons may play the same note. noteON is sent for each one, but noteOFF only for the last one.
2022-07-29 Changing patch or instrument now stops notes. Note numbers 0 no longer transferred. Code cleaned up.
    When changing patch or instrument type (2-row or 4-row) the currently playing notes are now stopped, to avoid noteOFF mismatch.
    If note number is 0 then it is no longer sent as noteON or noteOFF to the SamplerBox.
    Code has been cleaned up.
    [LeverHarmonica.ino]
2022-09-14 New pin and bank mapping, separate include files for midi notes and instrument patches, autodetect switch inversion.
    In the Aug/Sept 2022 update new PCBs were developed for lever and cherry key accordions. The key mapping has changed: instead of 6 banks we now have 8 banks.
    A new project was created: "LeverHarmonica_EightBanks_Sept2022" so that the old project (LeverHarmonica) is still compatible with our 1st iteration (wooden harmonica). In the new project separate header files are used for the midi note definitions and the instrument patch properties. These files could later be moved to a separate "include" directory so that these can be included by multiple Arduino projects (if needed).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
2022-11-23 Added EightBanks version of arduino code
2023-12-28 Implemented Native MIDI in LeverHarmonica_EightBanks script
    Native MIDI is now supported. Nano 33 IoT must be used as Arduino controller from now on. The older Nano 3.0 does not support native MIDI.
    The script is still backwards compatible with Patchbox-style MIDI-over-Serial-over-USB by setting NATIVE_MIDI = false.
2024-01-01 Implemented LEDs
    LEDs willl light up according to:
    depressed, decayTimeMs > decayMax: 10%
    depressed, decayTimeMs < decayMax: map(decayTimeMs, 0, 50, decayMax, 25)
    pressed: 100% (set decayTimeMs = 0)
    released: initially 50%, decays to 25% during one second
2024-01-28 Expanded some debugging code to help solving some issues
    Fix stuff
    [LeverHarmonica_EightBanks_Sept2022.ino]
2024-03-04 schematic for optocouplers
    [optocouplers.kicad_pcb, optocouplers.sch]
2024-03-04 update kicad drawings for optocouplers
    [optocouplers.kicad_pcb, optocouplers.sch]
2024-03-04 fix reference names on PCB
    [optocouplers.kicad_pcb]
2024-03-04 cherry-mx basses
    [cherry-basses.kicad_pcb, cherry-basses.sch]
2024-03-04 add arduino to cherry keys
    [cherry-basses.sch]
2024-03-04 Add labels to optocoupler board
2024-03-04 Update to the latest version of optocoupler pcb design
    [optocouplers.kicad_pcb, optocouplers.sch]
2024-03-04 Slightly change wiring of optocouplers
    [optocouplers.sch]
2024-03-04 Use correct components (.net) for optocouple board
2024-03-04 temp commit with pcb
    [optocouplers.kicad_pcb]
2024-03-04 intermediate step of optocoupler pcb
    [optocouplers.kicad_pcb]
2024-03-04 almost complete pcb
    [optocouplers.kicad_pcb, optocouplers.sch]
2024-03-04 Almost finished pcb
    [optocouplers.kicad_pcb]
2024-03-04 Finish cherry basses keyboard
    [cherry-basses.kicad_pcb, cherry-basses.sch]
2024-03-04 Add missing 2k resistors, change connectors (opto)
    [optocouplers.sch]
2024-03-04 Assign correct footprint of transistors, missing resistors
    [optocouplers.sch]
2024-03-04 Backup of optocouplers
    [optocouplers.kicad_pcb, optocouplers.sch]
2024-03-04 This change removed background fill from optocouplers board
    It was probably done by accident and might need reverting
    [optocouplers.kicad_pcb]
2024-03-04 [PCB] cherry basses: changes in lib
    Not exactly sure what these changes are ...
2024-03-04 cache lib for optocouplers PCB
2024-03-04 Save cherry basses with kicad 6
    [cherry-basses.kicad_pcb]
2024-03-04 Add edge cut to cherry basses
    [cherry-basses.kicad_pcb]
2024-03-04 Add two mounting holes and refill background of cherry basses
    [cherry-basses.kicad_pcb]
2024-03-04 Fix silkscreen text on cherry basses
    [cherry-basses.kicad_pcb]
2024-03-04 Add schematic for cherry treble
    [cherry-treble.kicad_sch]
2024-03-04 Pick compatible PCB components for cherry trebble
    [cherry-treble.kicad_sch]
2024-03-04 Copy of optocouplers (temporary)
    [optocouplers.kicad_pcb, optocouplers.sch]
2024-03-04 Add schematic for new optocouplers board
    [optocouplers.kicad_sch]
2024-03-04 unfinished changes in optocouplers board
    [optocouplers.kicad_pcb]
2024-03-04 remove all segments from optocouplers board
    [optocouplers.kicad_pcb]
2024-03-04 Update components
    [optocouplers.kicad_sch]
2024-03-04 No clue what changed
    [optocouplers.kicad_pcb]
2024-03-04 rename some components in schematic
    [optocouplers.kicad_sch]
2024-03-04 move a single optocoupler
    [optocouplers.kicad_pcb]
2024-03-04 Remove the drawing of a single optocoupler
    [optocouplers.kicad_pcb]
2024-03-04 Remove the background drawing of optocouplers
    [optocouplers.kicad_pcb]
2024-03-04 Move around optocouplers for rows A and C
    [optocouplers.kicad_pcb]
2024-03-04 Temporary move some resistors around
    [optocouplers.kicad_pcb]
2024-03-04 Rename elements on pcb
    [optocouplers.kicad_pcb]
2024-03-04 slightly align two resistors, update pcb from schematic, prepare before fixing names of components
    [optocouplers.kicad_pcb]
2024-03-04 remove segments
    [optocouplers.kicad_pcb]
2024-03-04 swap a1 and a6
    [optocouplers.kicad_pcb]
2024-03-04 Fix placements of components for the row A
    [optocouplers.kicad_pcb]
2024-03-04 Fix placement of row b
    [optocouplers.kicad_pcb]
2024-03-04 align optocouplers for line C
    [optocouplers.kicad_pcb]
2024-03-04 old sch file is no longer needed (optocouplers)
    [optocouplers.sch]
2024-03-04 fix placements of resistors for row c
    [optocouplers.kicad_pcb]
2024-03-04 fix placement of components for row D
    [optocouplers.kicad_pcb]
2024-03-04 rename uuids
    [optocouplers.kicad_pcb]
2024-03-04 change uuids of resistors
    [optocouplers.kicad_pcb]
2024-03-04 move resistors to the back of the list as they belong to the back cu
    [optocouplers.kicad_pcb]
2024-03-04 fix typo in resistor uuid
    [optocouplers.kicad_pcb]
2024-03-04 fix resistor location
    [optocouplers.kicad_pcb]
2024-03-04 straight lines
    [optocouplers.kicad_pcb]
2024-03-04 some nearly straight lines
    [optocouplers.kicad_pcb]
2024-03-04 Move optocouplers 1 mm higher (TODO: one resistor belongs to a different commit)
    [optocouplers.kicad_pcb]
2024-03-04 Move some resistors a bit
    [optocouplers.kicad_pcb]
2024-03-04 Remove paths
    [optocouplers.kicad_pcb]
2024-03-04 Place resistors R.R0 to R.R5
    [optocouplers.kicad_pcb]
2024-03-04 Simple connections between neighbours
    [optocouplers.kicad_pcb]
2024-03-04 5V line
    [optocouplers.kicad_pcb]
2024-03-04 Add some lines
    [optocouplers.kicad_pcb]
2024-03-04 More lines
    [optocouplers.kicad_pcb]
2024-03-04 Update wiring schematic for cherry treble
    [cherry-treble.kicad_sch]
2024-03-04 Unfinished PCB for cherry treble
    [cherry-treble.kicad_pcb]
2024-03-04 Exclude cherry switches from BOM
    [cherry-treble.kicad_sch]
2024-03-04 Update cherry treble PCB
    [cherry-treble.kicad_pcb]
2024-03-04 cherry basses pcb: no clue what changed
    [cherry-basses.kicad_pcb]
2024-03-04 Add Neltron connectors
2024-03-04 Update pcb for cherry basses
    - add connector for the side button
    - fix vias
    - fix positions of some diodes
    [cherry-basses.kicad_pcb]
2024-03-04 Move pushpull switch name on cherry basses
    [cherry-basses.kicad_pcb]
2024-03-04 Replace the cherry basses schematic with the new one
    [cherry-basses.kicad_sch, cherry-basses.sch]
2024-03-04 optocouplers schematic
    [optocouplers.kicad_sch]
2024-03-04 Move optocouplers to the correct place, shrink the board
    [optocouplers.kicad_pcb]
2024-03-04 Move connector closer to the keys on cherry treble
    Almost enforce the clearance
    [cherry-treble.kicad_pcb]
2024-03-04 Define clearance to 0.5 mm for cherry treble
2024-03-04 Move elements of the cherry treble PCB
    [cherry-treble.kicad_pcb]
2024-03-04 Potentially finished cherry treble pcb
    [cherry-treble.kicad_pcb]
2024-03-04 shrink cherry treble pcb by 2 mm on each side
    [cherry-treble.kicad_pcb]
2024-03-04 Shrink kicad treble, fix interline spacing
    [cherry-treble.kicad_pcb]
2024-03-04 Further dimension adjustments to cherry treble to fit into the box
    [cherry-treble.kicad_pcb]
2024-03-04 cherry basses: replace components for rendering, add some vias
    [cherry-basses.kicad_pcb, cherry-basses.kicad_sch]
2024-03-04 Refill zones
    [cherry-treble.kicad_pcb]
2024-03-04 Define origin
    [cherry-treble.kicad_pcb]
2024-03-04 Exclude connector on cherry treble from BOM
    [cherry-treble.kicad_pcb]
2024-03-04 Exclude connector from position file
    [cherry-treble.kicad_pcb]
2024-03-04 Remove cherry switches from assembly files
    [cherry-treble.kicad_pcb]
2024-03-04 Name the diodes on cherry treble
    [cherry-treble.kicad_sch]
2024-03-04 optocouplers: change footprints
    [optocouplers.kicad_sch]
2024-03-04 Add part numbers for resistors in cherry treble schematics
    [cherry-treble.kicad_sch]
2024-03-04 Add exclude_from_bom to cherry treble
    [cherry-treble.kicad_pcb]
2024-03-04 Rename diodes on the PCB (probably not needed, might be reverted)
    [cherry-treble.kicad_pcb]
2024-03-04 Add LCSC part # for resistors
    [cherry-treble.kicad_pcb]
2024-03-04 Exclude mounting holes from assembly
    [cherry-treble.kicad_pcb]
2024-03-04 optocouplers, continue wiring
    [optocouplers.kicad_pcb]
2024-03-04 Move the whole optocouplers board a bit up, finish tracing
    [optocouplers.kicad_pcb]
2024-03-04 Add LCSC part numbers for the optocoupler schematics
    [optocouplers.kicad_sch]
2024-03-04 Add part numbers to optocouplers
    [optocouplers.kicad_pcb]
2024-03-04 gerber settings for optocouplers
    [optocouplers.kicad_pcb]
2024-03-04 Refill optocouplers pcb
    [optocouplers.kicad_pcb]
2024-03-04 Blue cherry treble board
    [cherry-treble.kicad_pcb]
2024-03-04 Replace diode symbols on cherry treble
    [cherry-treble.kicad_sch]
2024-03-04 Update diodes from schematic and fix polarity on cherry treble pcb
    [cherry-treble.kicad_pcb]
2024-03-04 Avoid 90 degree corners in cherry treble pcb
    [cherry-treble.kicad_pcb]
2024-03-04 Autoplace fields on cherry treble schematics
    [cherry-treble.kicad_sch]
2024-03-04 Add kicad & osh symbols to cherry treble pcb
    [cherry-treble.kicad_pcb]
2024-03-04 Fix part number for the schottky diodes
    [cherry-treble.kicad_sch]
2024-03-04 Update part numbers for the schottky diodes plus whatever refill took place
    [cherry-treble.kicad_pcb]
2024-03-04 Replace rescued elements with proper / newer ones
    [optocouplers.kicad_sch]
2024-03-04 Use the new footprint for ITR9608
    [optocouplers.kicad_sch]
2024-03-04 Update footprints for optocouplers in the PCB
    [optocouplers.kicad_pcb]
2024-03-04 Add text to the optocouplers pcb
    [optocouplers.kicad_pcb]
2024-03-04 Add OSH and KiCad logos on the silkscreen
    [optocouplers.kicad_pcb]
2024-03-04 Add arduino port labels
    [optocouplers.kicad_pcb]
2024-03-04 Make pcb blue
    [optocouplers.kicad_pcb]
2024-03-04 Replace pspice diodes with proper schottky diodes on cherry basses schematics
    [cherry-basses.kicad_sch]
2024-03-04 cherry basses: update color, fix diode orientation, remove border from silk screen
    [cherry-basses.kicad_pcb]
2024-03-04 Replace mounting holes and update components from library (cherry basses)
    [cherry-basses.kicad_pcb]
2024-03-04 Add labels to the connector
    [cherry-basses.kicad_pcb]
2024-03-04 Add osh logo
    [cherry-basses.kicad_pcb]
2024-03-04 Some rounding changes to the cherry basses pcb
    [cherry-basses.kicad_pcb]
2024-03-04 First arduino plate PCB
    [arduino-plate.kicad_pcb, arduino-plate.kicad_sch]
2024-03-04 Updates to arduino
    [arduino-plate.kicad_pcb, arduino-plate.kicad_sch]
2024-03-04 LED strip schematic & pcb
    [led-strip.kicad_pcb, led-strip.kicad_sch]
2024-03-04 Move led-strip schematic a bit
    [led-strip.kicad_sch]
2024-03-04 led strip project update
2024-03-04 led strip pcb: improve pad connections at the end, positive polarity zone ipd.
    [led-strip.kicad_pcb]
2024-03-04 Unplace axis origin
    [led-strip.kicad_pcb]
2024-03-04 Schematic for the LED strip for levers
    [led-strip-levers.kicad_sch]
2024-03-04 led strip levers: unfinished PCB
    [led-strip-levers.kicad_pcb]
2024-03-04 First version of RPi audio hat
    [rpi-audio-hat.kicad_pcb, rpi-audio-hat.kicad_sch]
2024-03-04 Add footprint for a mini toggle SPDT switch B068BW
2024-03-05 rpi-audio-hat: upgrade schematic to KiCad and remove side rows for rpi
    [rpi-audio-hat.kicad_sch]
2024-03-05 Update PCB for RPi audio hat
    [rpi-audio-hat.kicad_pcb, rpi-audio-hat.kicad_sch]
2024-03-05 3D model for screw terminal
2024-03-05 3D model for the switch
2024-03-05 Update switch to KiCad8, add a link to 3D model
2024-03-05 Add footprint for PCM5102 module
2024-03-05 Add footprint for PAM8302
2024-03-05 Update RPi hat pcb
    [rpi-audio-hat.kicad_pcb]
2024-03-06 Work on schematic
    [Battery charger.kicad_sch, DAC.kicad_sch, Power.kicad_sch, Stereo amplifier.kicad_sch, rpi-audio-hat.kicad_pcb, rpi-audio-hat.kicad_sch]
2024-03-06 Save PCB
    [rpi-audio-hat.kicad_pcb]
2024-03-06 Fix power switch & symbol update
    [Battery charger.kicad_sch, Power.kicad_sch, Stereo amplifier.kicad_sch, rpi-audio-hat.kicad_sch]
2024-03-07 Fix TLV761
    [Power.kicad_sch]
